A-ry-A/RobotSTM32Board/Robot_BMS/images/Robot_BMS_V1.png

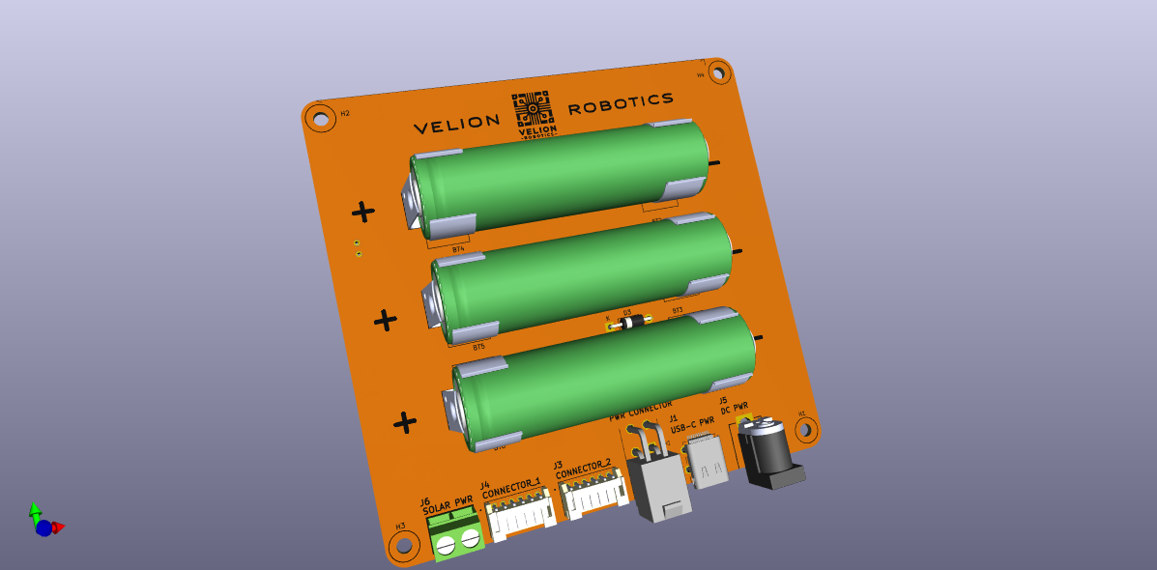
Robot_BMS/images/Robot_BMS_V1.png
