A-ry-A/RobotSTM32Board/Robot_BMS/images/boardlayout.jpg

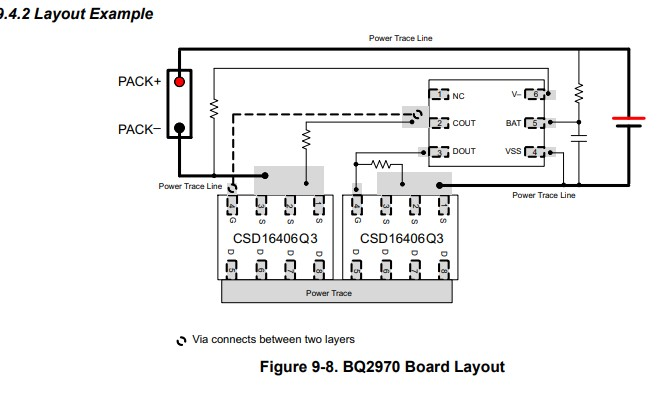
Robot_BMS/images/boardlayout.jpg
