A-ry-A/RobotSTM32Board/Robot_BMS/39-30-0040/3D/39-30-0040.stp

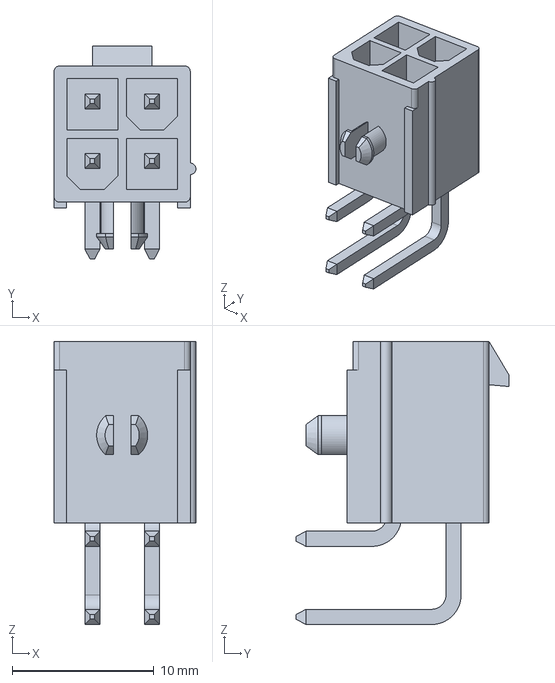
[picture p3: CAD file, 2025-03-24]
Robot_BMS/39-30-0040/3D/39-30-0040.stp
10.0 x 15.0 x 19.9 mm
