A-ry-A/RobotSTM32Board/Robot_BMS/BK_18650_CLIP (1)/BK-18650-CLIP.step

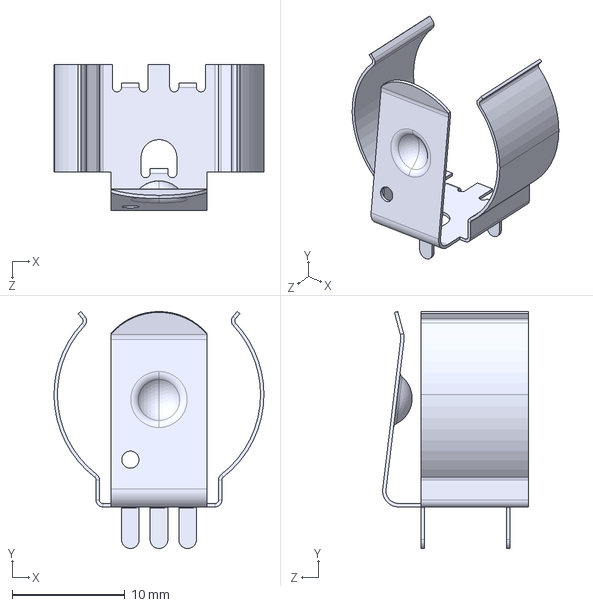
[picture p4: CAD file, 2025-03-24]
Robot_BMS/BK_18650_CLIP (1)/BK-18650-CLIP.step
18.6 x 21.0 x 12.9 mm
