A-ry-A/RobotSTM32Board/Robot_BMS/ERA-3AED512V/3D/ERA-3AED512V.stp

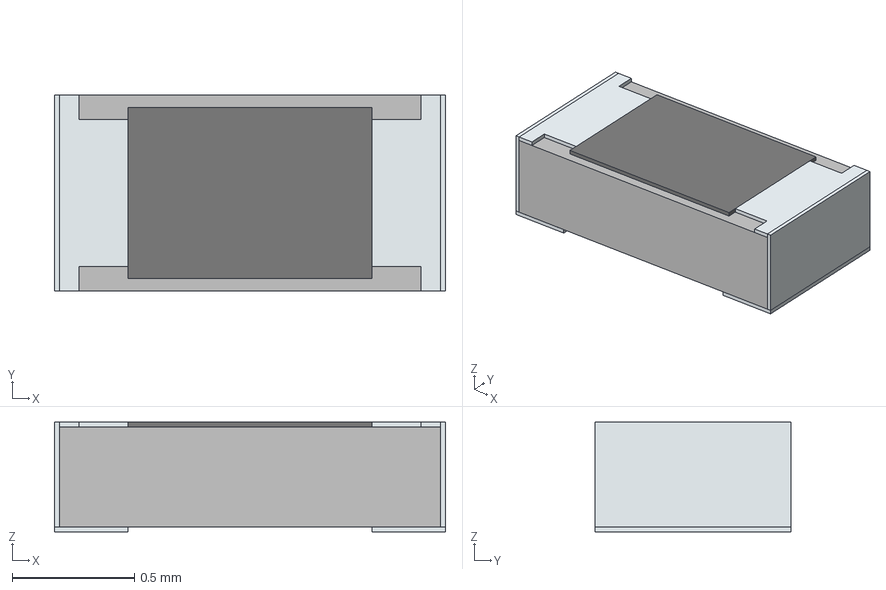
[picture p5: CAD file, 2025-03-24]
Robot_BMS/ERA-3AED512V/3D/ERA-3AED512V.stp
1.60 x 0.8 x 0.45 mm
solidBody
solidTop
solidTerminal1
solidTerminal2
solidTerminal3
