A-ry-A/RobotSTM32Board/Robot_BMS/NCP03XH103F05RL/3D/NCP03XH103F05RL.stp

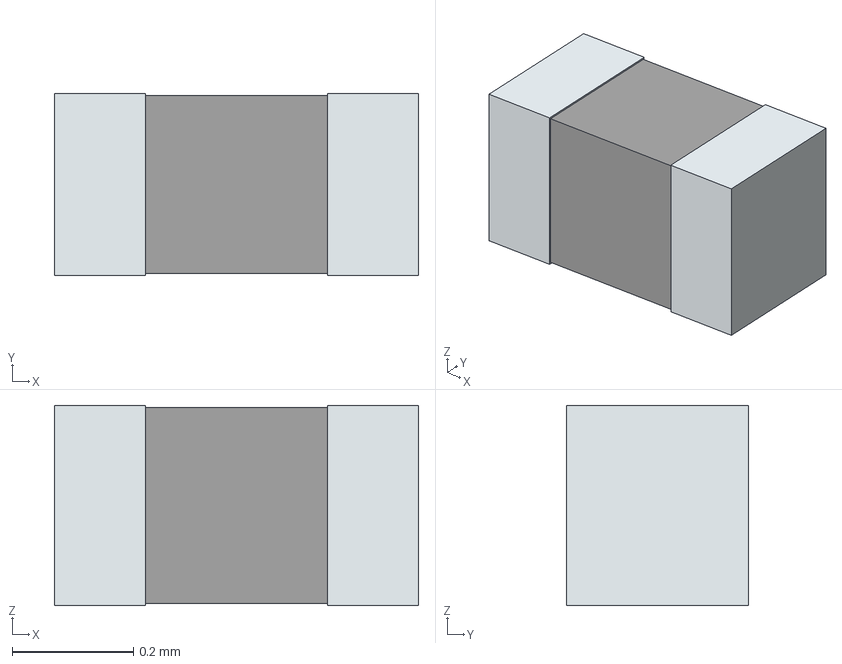
[picture p6: CAD file, 2025-03-24]
Robot_BMS/NCP03XH103F05RL/3D/NCP03XH103F05RL.stp
0.6 x 0.3 x 0.33 mm
term1
term2
