A-ry-A/RobotSTM32Board/Robot_BMS/Passive Components/AT0603DRE07100RL/AT0603DRE07100RL.step

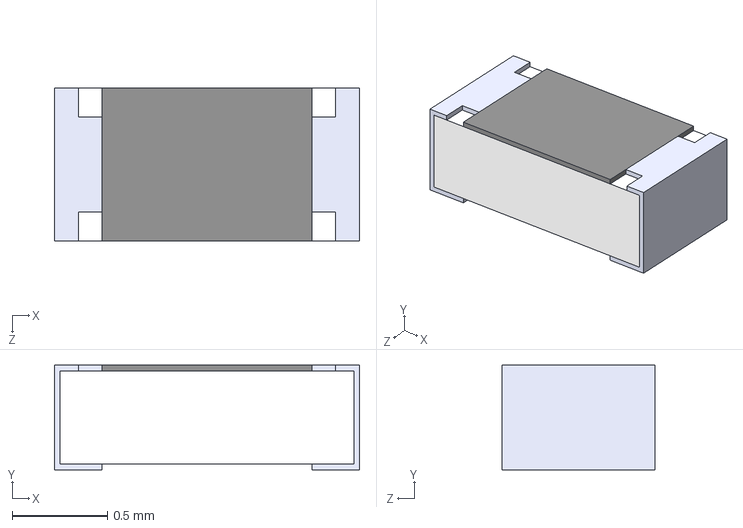
[picture p7: CAD file, 2025-03-19]
Robot_BMS/Passive Components/AT0603DRE07100RL/AT0603DRE07100RL.step
1.60 x 0.55 x 0.8 mm
