A-ry-A/RobotSTM32Board/Robot_BMS/Passive Components/CC0603KRX7R6BB184/CC0603KRX7R6BB184.step

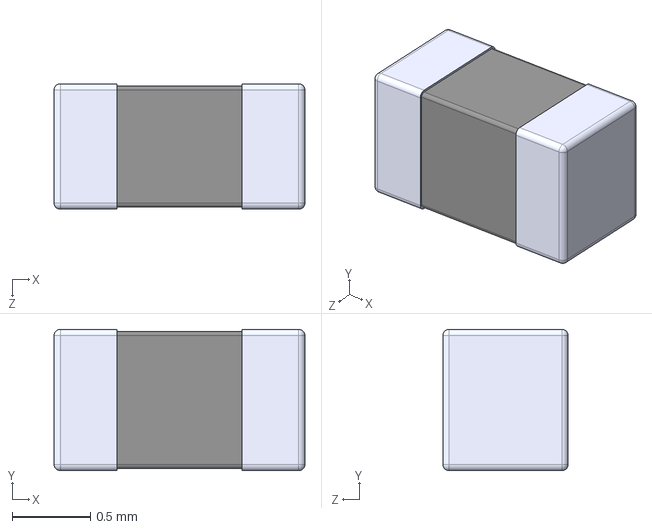
[picture p8: CAD file, 2025-03-19]
Robot_BMS/Passive Components/CC0603KRX7R6BB184/CC0603KRX7R6BB184.step
1.60 x 0.9 x 0.8 mm
