A-ry-A/RobotSTM32Board/Robot_BMS/Passive Components/CL10A106MA8NRNC/3D/CL10A106MA8NRNC.stp

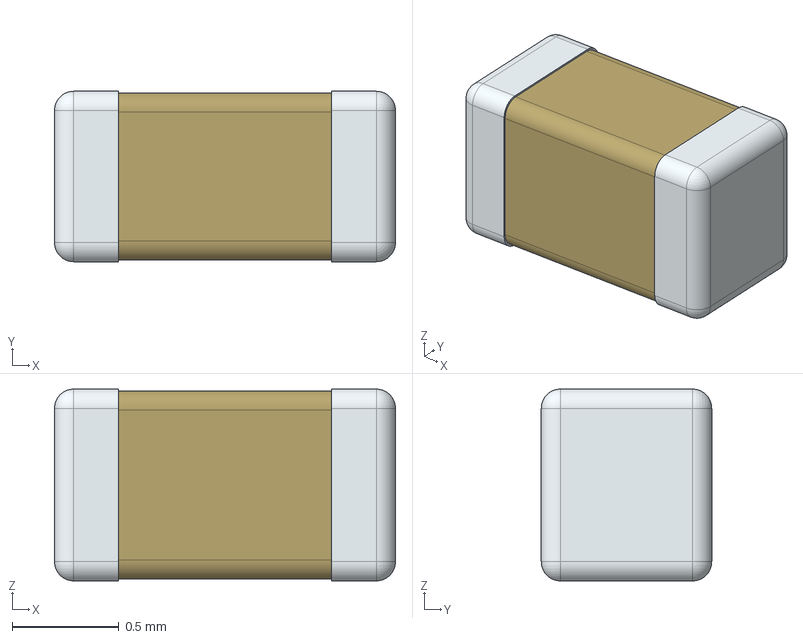
[picture p9: CAD file, 2025-03-19]
Robot_BMS/Passive Components/CL10A106MA8NRNC/3D/CL10A106MA8NRNC.stp
1.60 x 0.8 x 0.9 mm
