A-ry-A/RobotSTM32Board/Robot_BMS/Passive Components/CRCW0603110KFKEAC/CRCW0603110KFKEAC.step

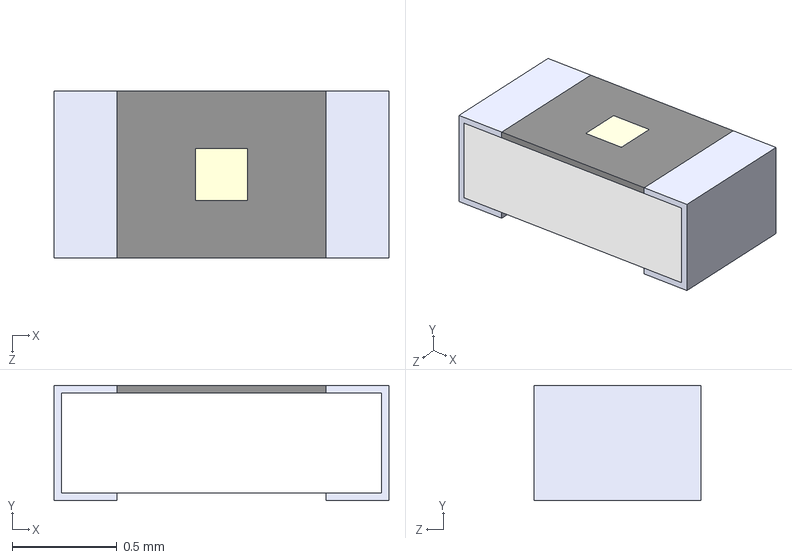
[picture p10: CAD file, 2025-03-19]
Robot_BMS/Passive Components/CRCW0603110KFKEAC/CRCW0603110KFKEAC.step
1.60 x 0.55 x 0.8 mm
