A-ry-A/RobotSTM32Board/Robot_BMS/Passive Components/CRCW060340K2FKEAHP/CRCW060340K2FKEAHP.step

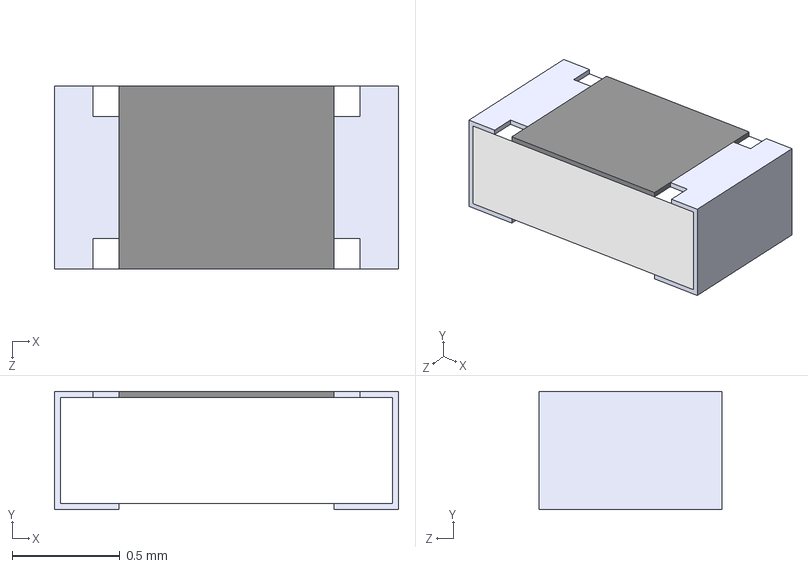
[picture p11: CAD file, 2025-03-19]
Robot_BMS/Passive Components/CRCW060340K2FKEAHP/CRCW060340K2FKEAHP.step
1.60 x 0.55 x 0.85 mm
