A-ry-A/RobotSTM32Board/Robot_BMS/Passive Components/CRCW0603604RFKEA/CRCW0603604RFKEA.step

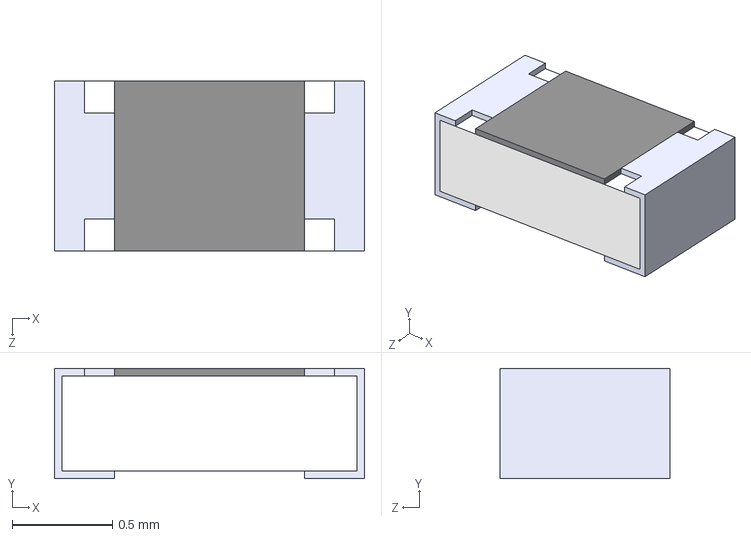
[picture p12: CAD file, 2025-03-19]
Robot_BMS/Passive Components/CRCW0603604RFKEA/CRCW0603604RFKEA.step
1.55 x 0.55 x 0.85 mm
