A-ry-A/RobotSTM32Board/Robot_BMS/Passive Components/ERJPA3F20R0V/ERJPA3F20R0V.step

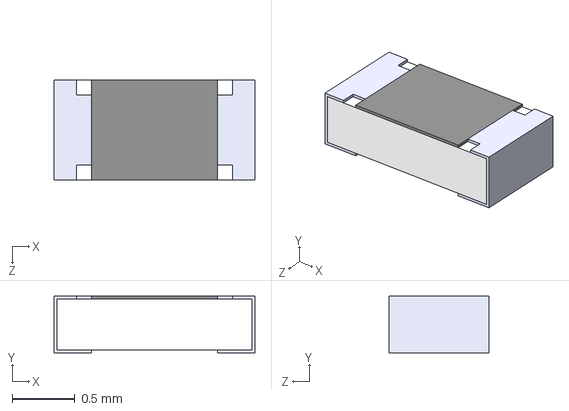
[picture p13: CAD file, 2025-03-19]
Robot_BMS/Passive Components/ERJPA3F20R0V/ERJPA3F20R0V.step
1.60 x 0.45 x 0.8 mm
