A-ry-A/RobotSTM32Board/Robot_BMS/Passive Components/GA0603A101JXBAC31G/GA0603A101JXBAC31G.step

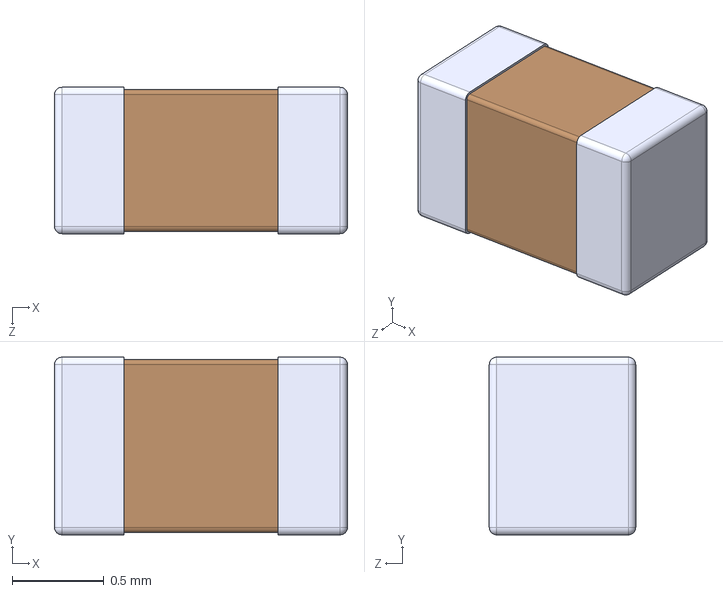
[picture p14: CAD file, 2025-03-19]
Robot_BMS/Passive Components/GA0603A101JXBAC31G/GA0603A101JXBAC31G.step
1.60 x 0.97 x 0.8 mm
