A-ry-A/RobotSTM32Board/Robot_BMS/Passive Components/LIB_ETQ-P5M220YSC/ETQ-P5M220YSC/3D/ETQ-P5M220YSC.stp

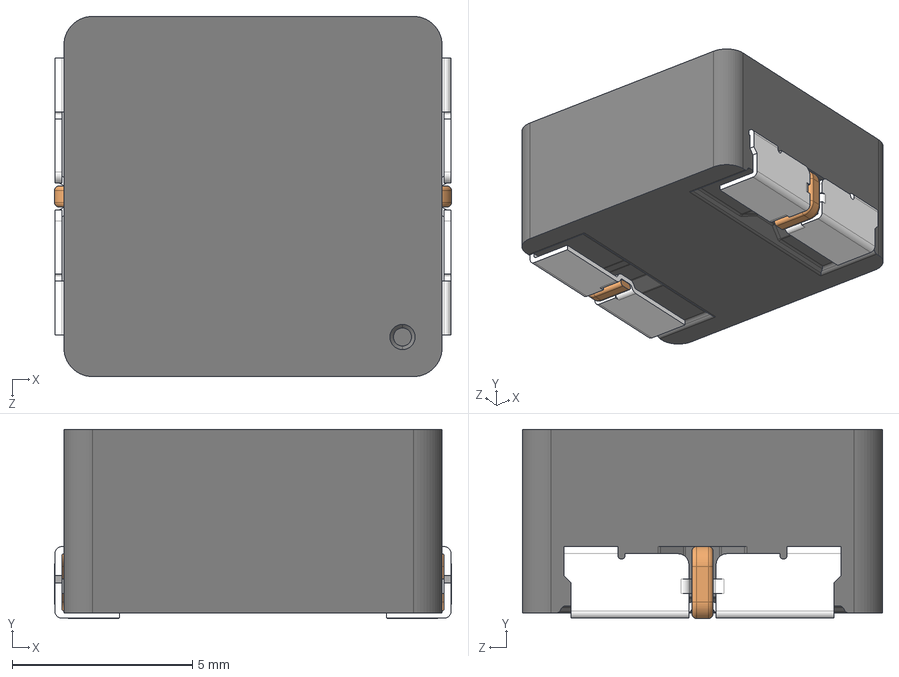
[picture p15: CAD file, 2025-03-19]
Robot_BMS/Passive Components/LIB_ETQ-P5M220YSC/ETQ-P5M220YSC/3D/ETQ-P5M220YSC.stp
11.0 x 5.25 x 10.0 mm
