A-ry-A/RobotSTM32Board/Robot_BMS/Passive Components/NTCLE100E3103HB0/NTCLE100E3102.step

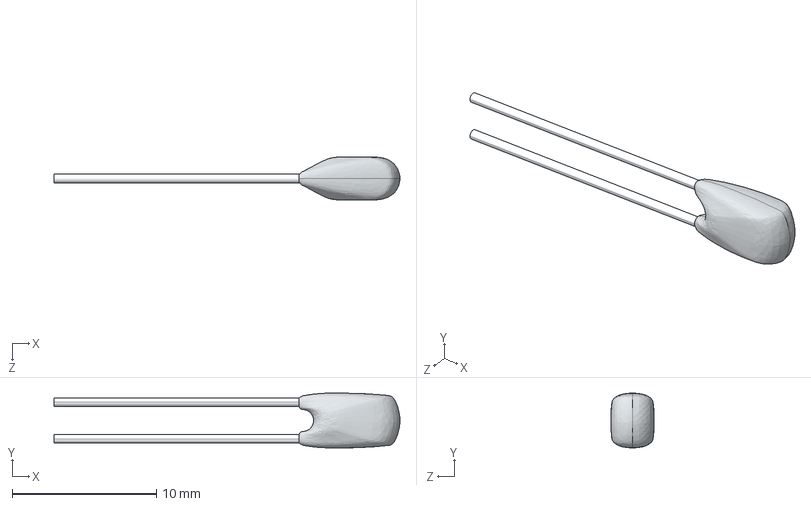
[picture p16: CAD file, 2025-03-19]
Robot_BMS/Passive Components/NTCLE100E3103HB0/NTCLE100E3102.step
24.0 x 3.80 x 3.00 mm
