A-ry-A/RobotSTM32Board/Robot_BMS/Passive Components/RC0603FR_073K24L/RC0603N_YAG.step

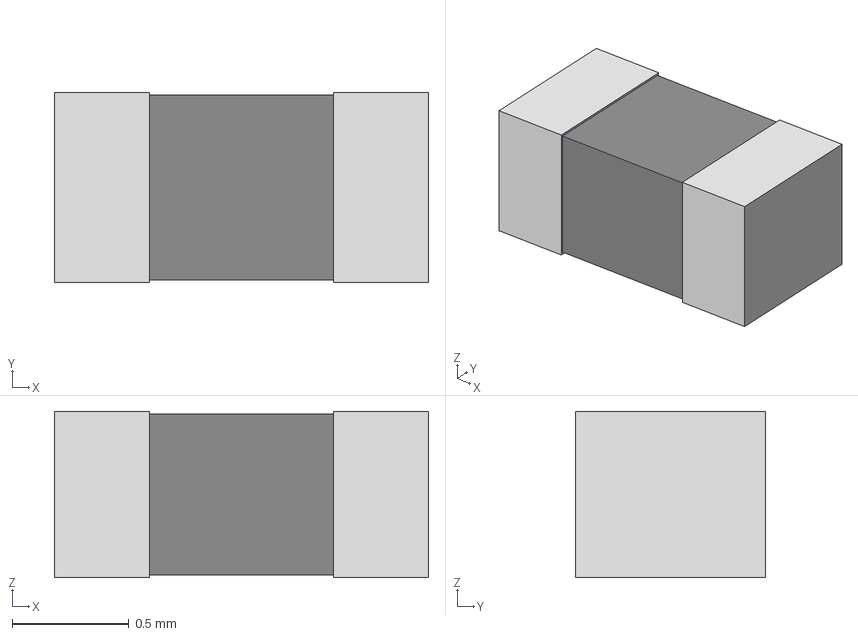
[picture p17: CAD file, 2025-03-19]
Robot_BMS/Passive Components/RC0603FR_073K24L/RC0603N_YAG.step
1.60 x 0.812 x 0.711 mm
