A-ry-A/RobotSTM32Board/Robot_BMS/Passive Components/RN73H1JTTD4811B25/RN73H1JTTD4811B25.step

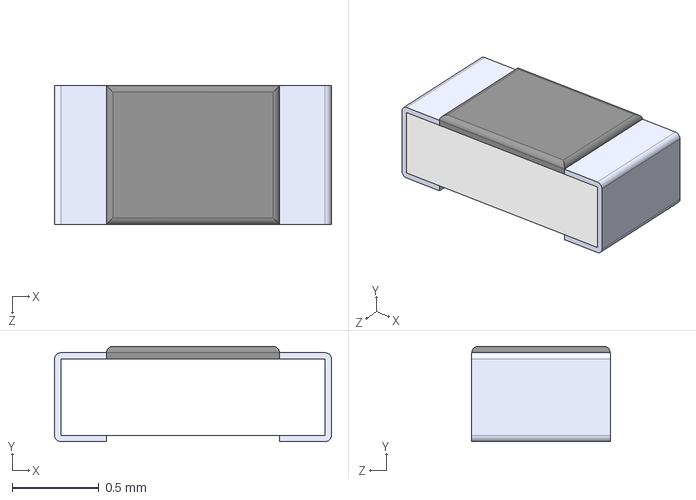
[picture p18: CAD file, 2025-03-19]
Robot_BMS/Passive Components/RN73H1JTTD4811B25/RN73H1JTTD4811B25.step
1.60 x 0.55 x 0.8 mm
