A-ry-A/RobotSTM32Board/Robot_BMS/Passive Components/ul_C0603C104K5RACAUTO/CCS_CCSTD_0603_L1.75W0.95T0.87B0.35.step

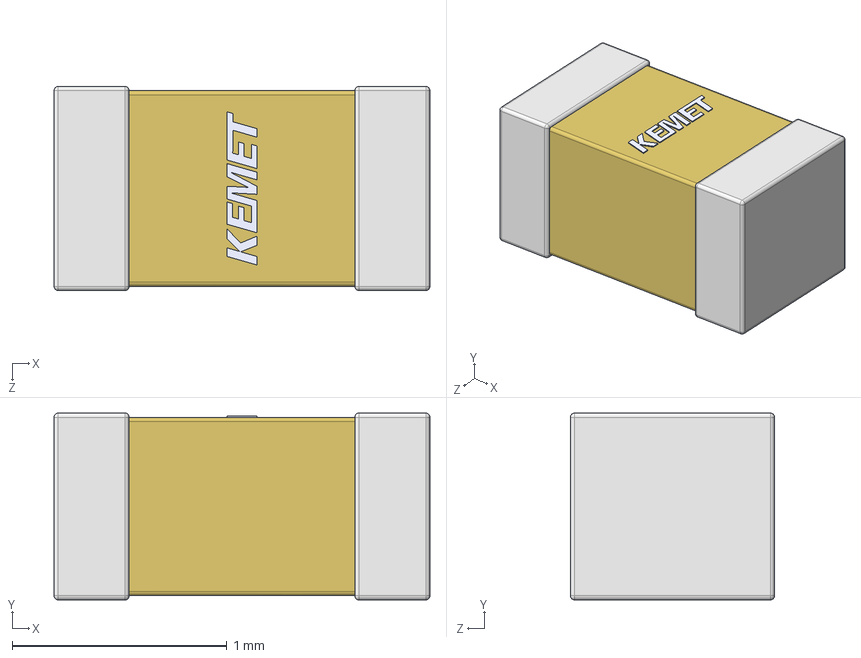
[picture p19: CAD file, 2025-03-19]
Robot_BMS/Passive Components/ul_C0603C104K5RACAUTO/CCS_CCSTD_0603_L1.75W0.95T0.87B0.35.step
1.75 x 0.87 x 0.95 mm
