A-ry-A/RobotSTM32Board/Robot_BMS/Passive Components/ul_C0603X821K5RACTU/CCS_CCSTD_0603_L1.77W0.95T0.95B0.45.step

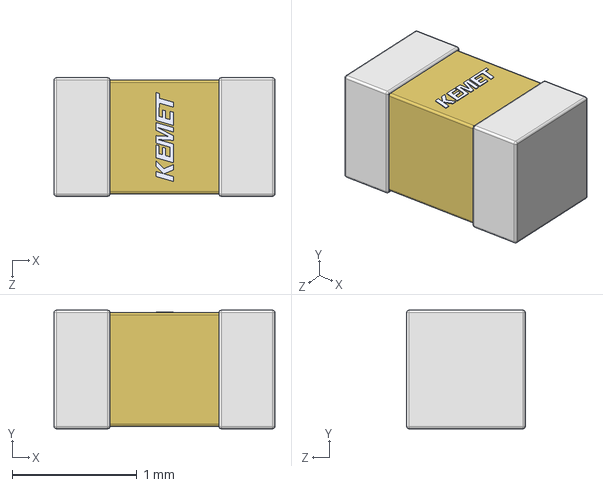
[picture p20: CAD file, 2025-03-19]
Robot_BMS/Passive Components/ul_C0603X821K5RACTU/CCS_CCSTD_0603_L1.77W0.95T0.95B0.45.step
1.77 x 0.95 x 0.95 mm
