A-ry-A/RobotSTM32Board/Robot_BMS/Passive Components/ul_C1608X5R1H105K080AB/CAP_1608_TDK.step

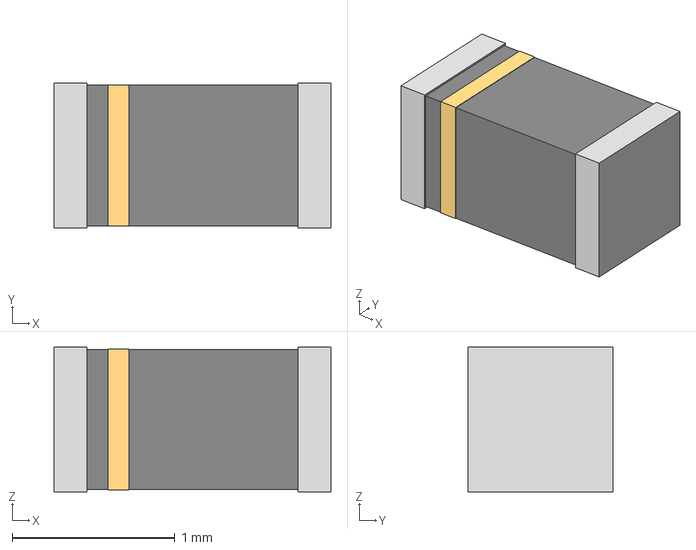
[picture p21: CAD file, 2025-03-19]
Robot_BMS/Passive Components/ul_C1608X5R1H105K080AB/CAP_1608_TDK.step
1.70 x 0.888 x 0.889 mm
