A-ry-A/RobotSTM32Board/Robot_BMS/Passive Components/ul_CRCW06031K00JNEAIF/RES_V0603_VIS.step

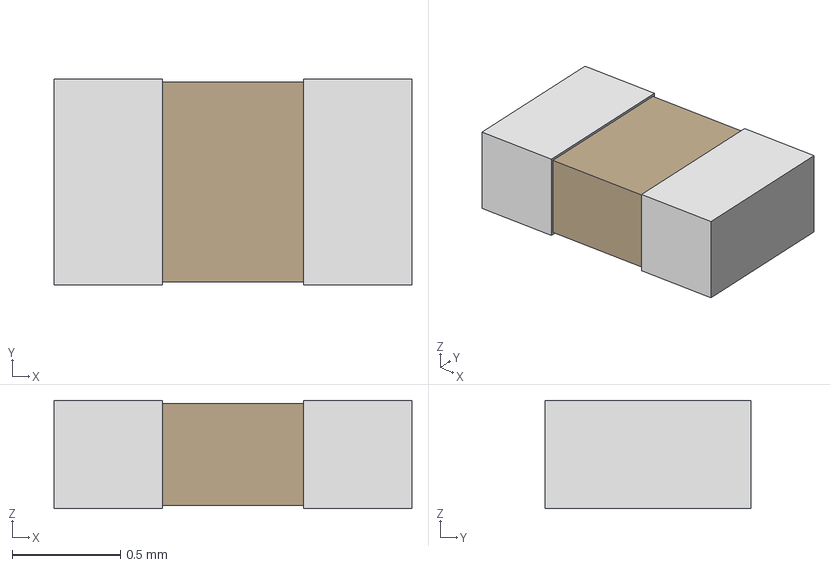
[picture p22: CAD file, 2025-03-19]
Robot_BMS/Passive Components/ul_CRCW06031K00JNEAIF/RES_V0603_VIS.step
1.65 x 0.95 x 0.5 mm
