A-ry-A/RobotSTM32Board/Robot_BMS/Passive Components/ul_ESR03EZPF1003/RES_R0603_ROM.step

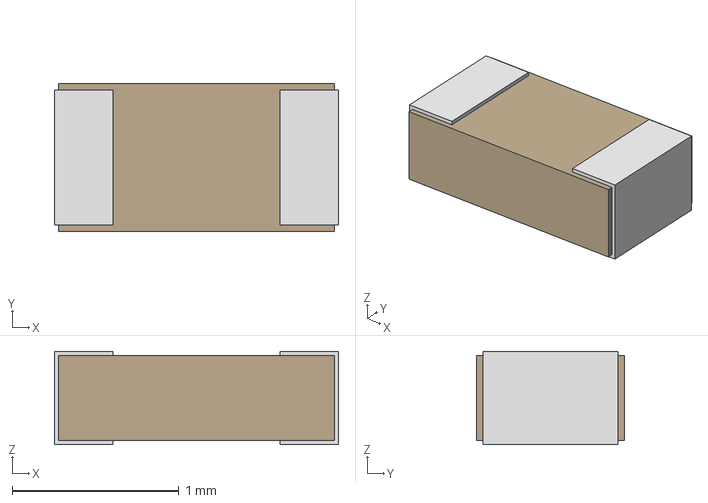
[picture p23: CAD file, 2025-03-19]
Robot_BMS/Passive Components/ul_ESR03EZPF1003/RES_R0603_ROM.step
1.70 x 0.888 x 0.559 mm
