A-ry-A/RobotSTM32Board/Robot_BMS/Passive Components/ul_GRM188R61H225KE11D/CAP_GRM188R61H225KE11__MUR.step

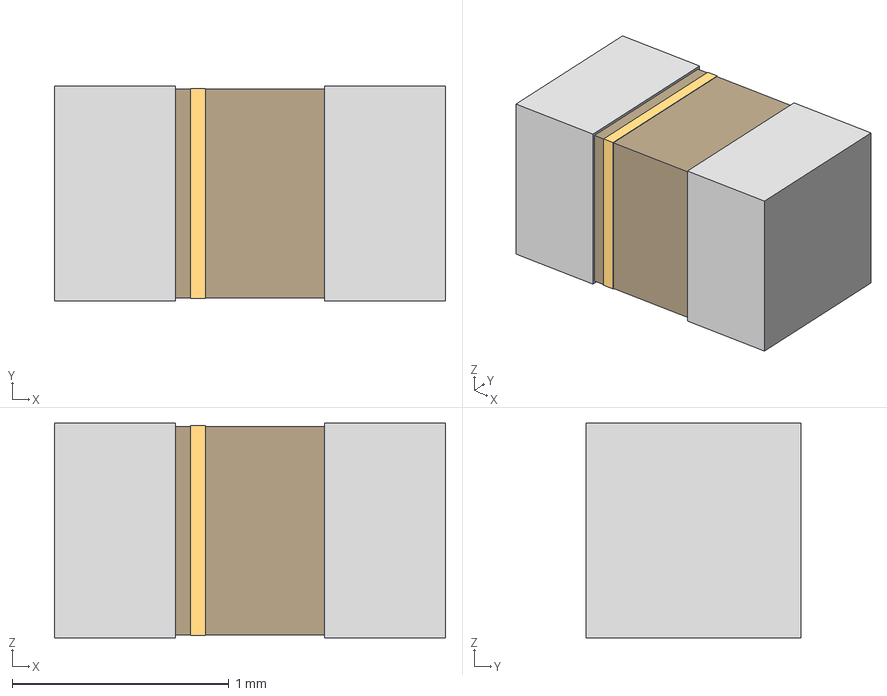
[picture p24: CAD file, 2025-03-19]
Robot_BMS/Passive Components/ul_GRM188R61H225KE11D/CAP_GRM188R61H225KE11__MUR.step
1.80 x 0.99 x 0.991 mm
