A-ry-A/RobotSTM32Board/Robot_BMS/Passive Components/ZRB18AR6YA475ME05L/ZRB18AR6YA475ME05L.step

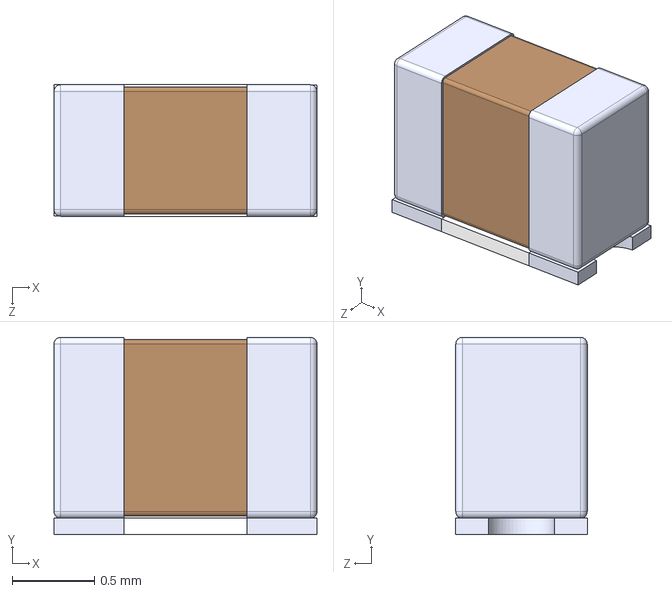
[picture p25: CAD file, 2025-03-19]
Robot_BMS/Passive Components/ZRB18AR6YA475ME05L/ZRB18AR6YA475ME05L.step
1.60 x 1.20 x 0.8 mm
