A-ry-A/RobotSTM32Board/Robot_BMS/PRT-13113/3D/PRT-13113.stp

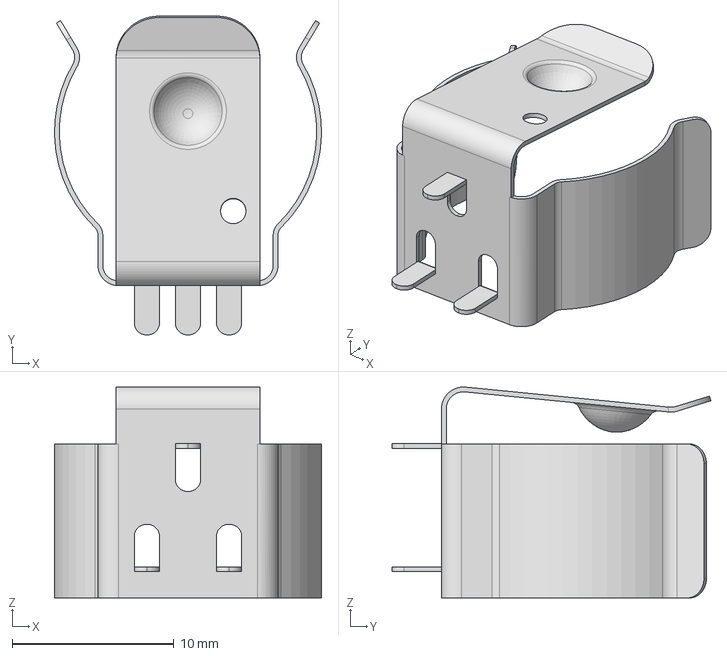
[picture p26: CAD file, 2025-04-03]
Robot_BMS/PRT-13113/3D/PRT-13113.stp
16.5 x 19.7 x 13.0 mm
