A-ry-A/RobotSTM32Board/Robot_BMS/Robot_BMS.step

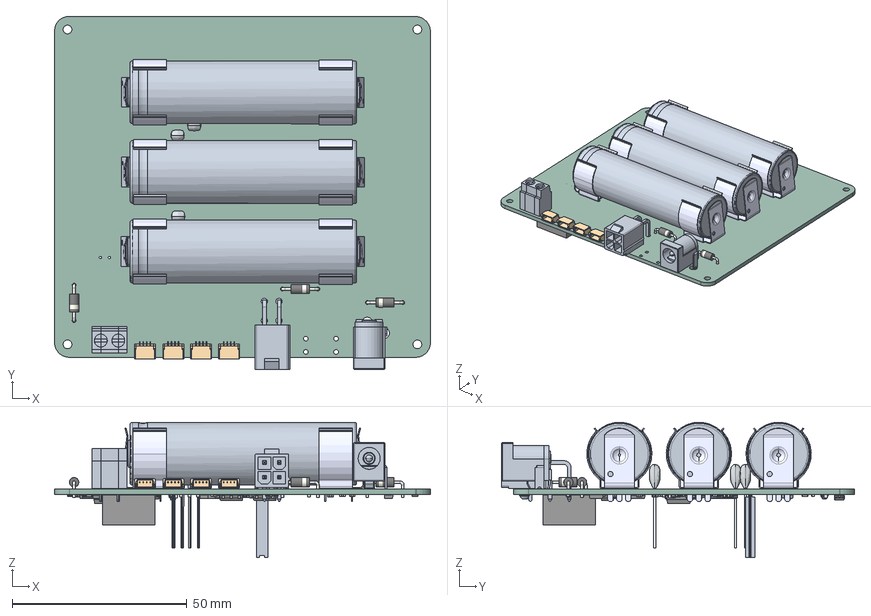
[picture p27: CAD file, 2025-04-18]
Robot_BMS/Robot_BMS.step
107.5 x 100.9 x 38.7 mm
SM04B-SRSS-TB(LFSN) x 4
DCJ200-10-A-K1-K
D_DO-41_SOD81_P10.16mm_Horizontal x 3
BK-18650-CLIP x 6
NTCLE100bModel2 STP x 3
18650 Battery 01A v1 x 3
Assem1
RSN0032B_ASM
DGK8
DQJ0008A_ASM
ERJ3RSFR10V x 6
SOT_223 x 2
ASSEMBLY x 5
SOT_23_6
ESR03EZPF1001 x 7
SQ7415AEN-T1 x 2
SOT_23 x 2
SMCJ15A-13-F
MF-USML_12-t3
Robot_BMS_PCB
