A-ry-A/RobotSTM32Board/Robot_BMS/S6B-PH-K-S_LF__SN_/S6B-PH-K-S_LF__SN_.step

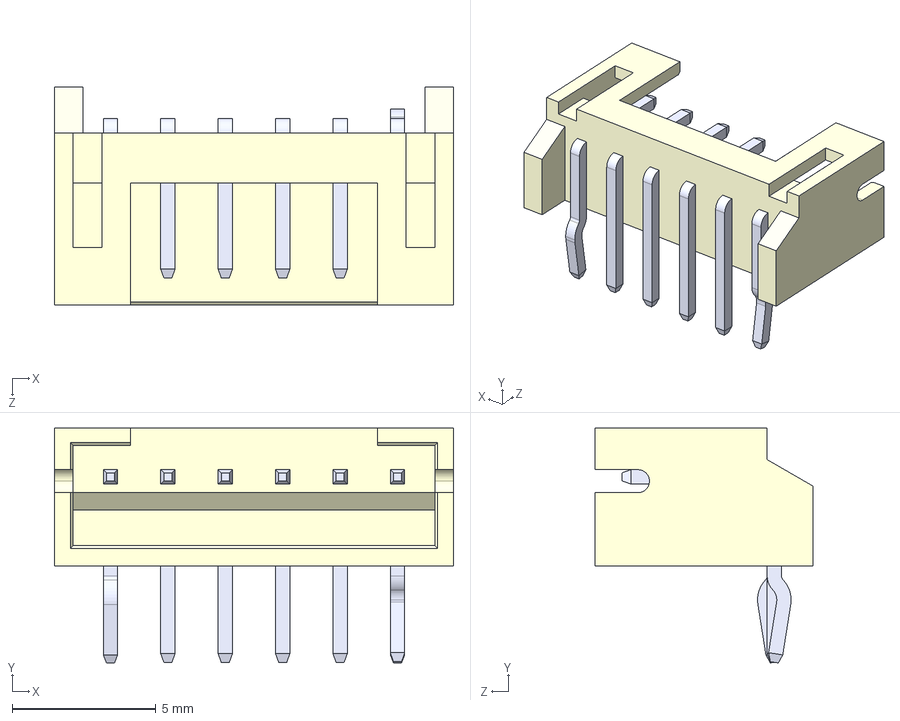
[picture p28: CAD file, 2025-03-24]
Robot_BMS/S6B-PH-K-S_LF__SN_/S6B-PH-K-S_LF__SN_.step
13.9 x 8.18 x 7.60 mm
