A-ry-A/RobotSTM32Board/Robot_BMS/UJC-H-G-SMT-2-P6-TR/3D/UJC-H-G-SMT-2-P6-TR.stp

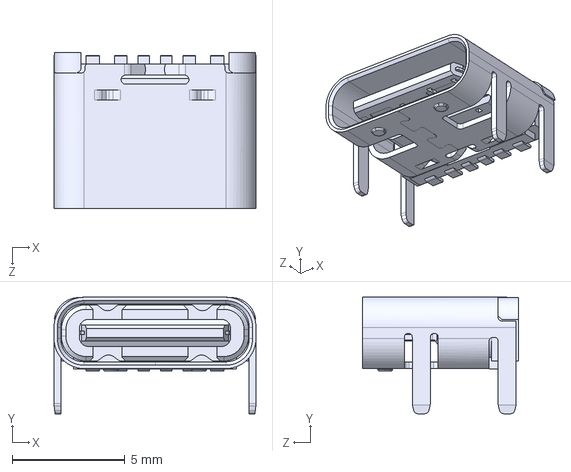
[picture p29: CAD file, 2025-04-01]
Robot_BMS/UJC-H-G-SMT-2-P6-TR/3D/UJC-H-G-SMT-2-P6-TR.stp
8.94 x 5.16 x 6.90 mm
