A-ry-A/RobotSTM32Board/Robot_BMS/ul_MF-LSMF500-16X-2/MF-USML450_12.stp

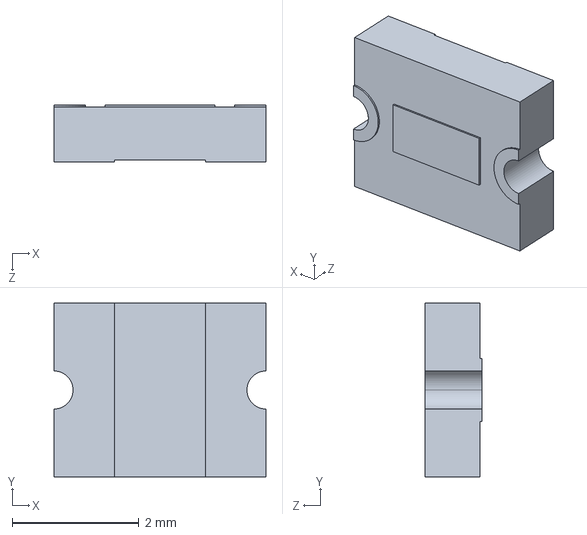
[picture p30: CAD file, 2025-03-24]
Robot_BMS/ul_MF-LSMF500-16X-2/MF-USML450_12.stp
3.34 x 2.74 x 0.9 mm
