A-ry-A/RobotSTM32Board/Robot_BMS/UR73D1JTTD10L0F/3D/UR73D1JTTD10L0F.stp

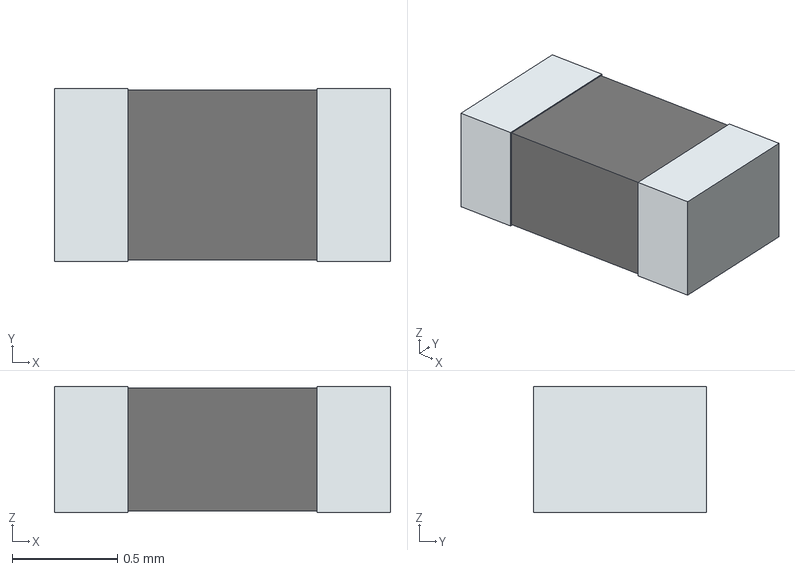
[picture p31: CAD file, 2025-03-24]
Robot_BMS/UR73D1JTTD10L0F/3D/UR73D1JTTD10L0F.stp
1.60 x 0.825 x 0.6 mm
term1
term2
