A-ry-A/RobotSTM32Board/TB6612FNG/TB6612FNG.step

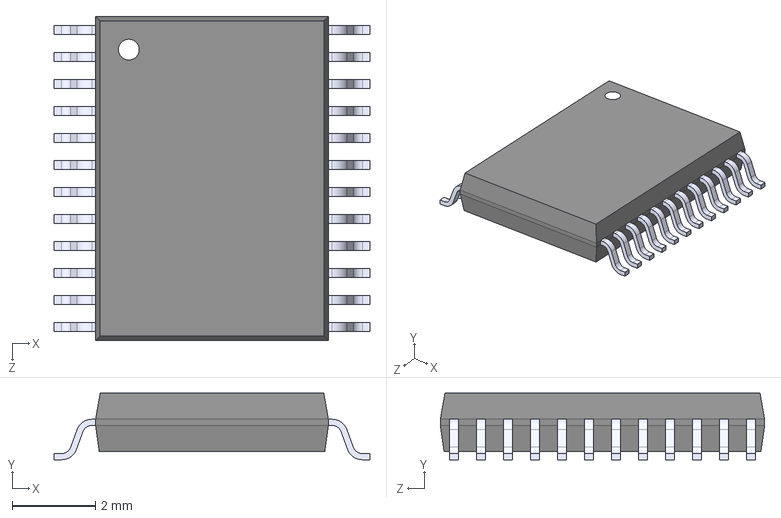
[picture p32: CAD file, 2025-03-03]
TB6612FNG/TB6612FNG.step
7.60 x 1.60 x 7.80 mm
