A-ry-A/RobotSTM32Board/(list of files, cad)

Other CAD files:
Robot_BMS/Passive Components/ul_C1608X5R1H474K080AB/CAP_1608_TDK.step
Robot_BMS/Passive Components/ul_RC0603FR-0710KL/RC0603N_YAG.step
Robot_BMS/AP33772DKZ-13/3D/AP33772DKZ-13.stp
