A-ry-A/RobotSTM32Board/Robot_BMS/Robot_BMS.kicad_pcb

## KiCad design Robot_BMS/Robot_BMS.kicad_pcb (2025-04-18)

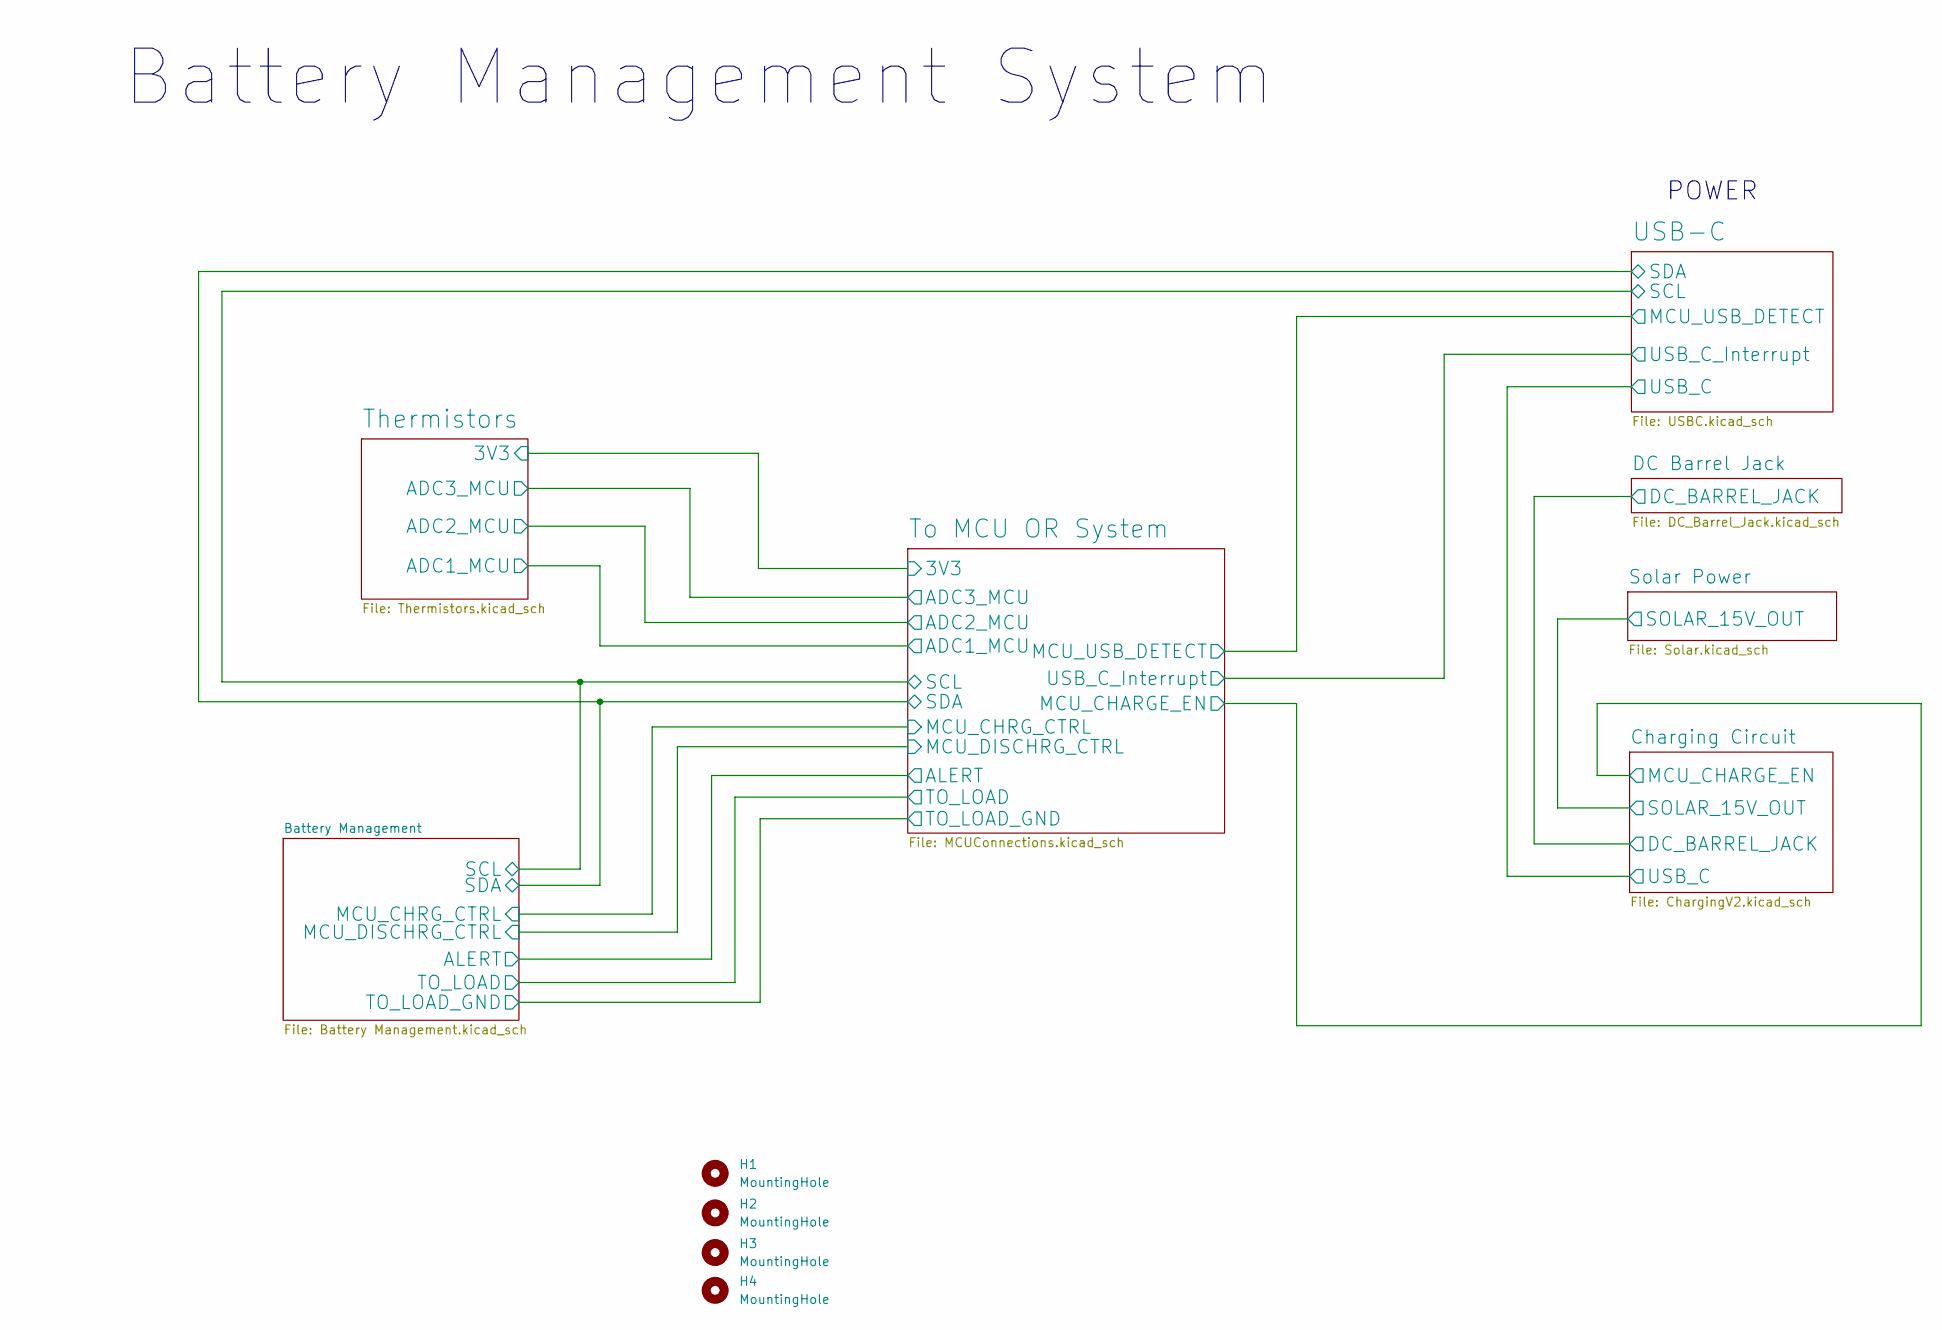
[picture p33: schematic Robot_BMS.kicad_sch, Battery Management System]

Parts:
H1, H2, H3, H4: MountingHole; MountingHole_2.5mm

Notes on the sheet:
POWER
Battery Management System

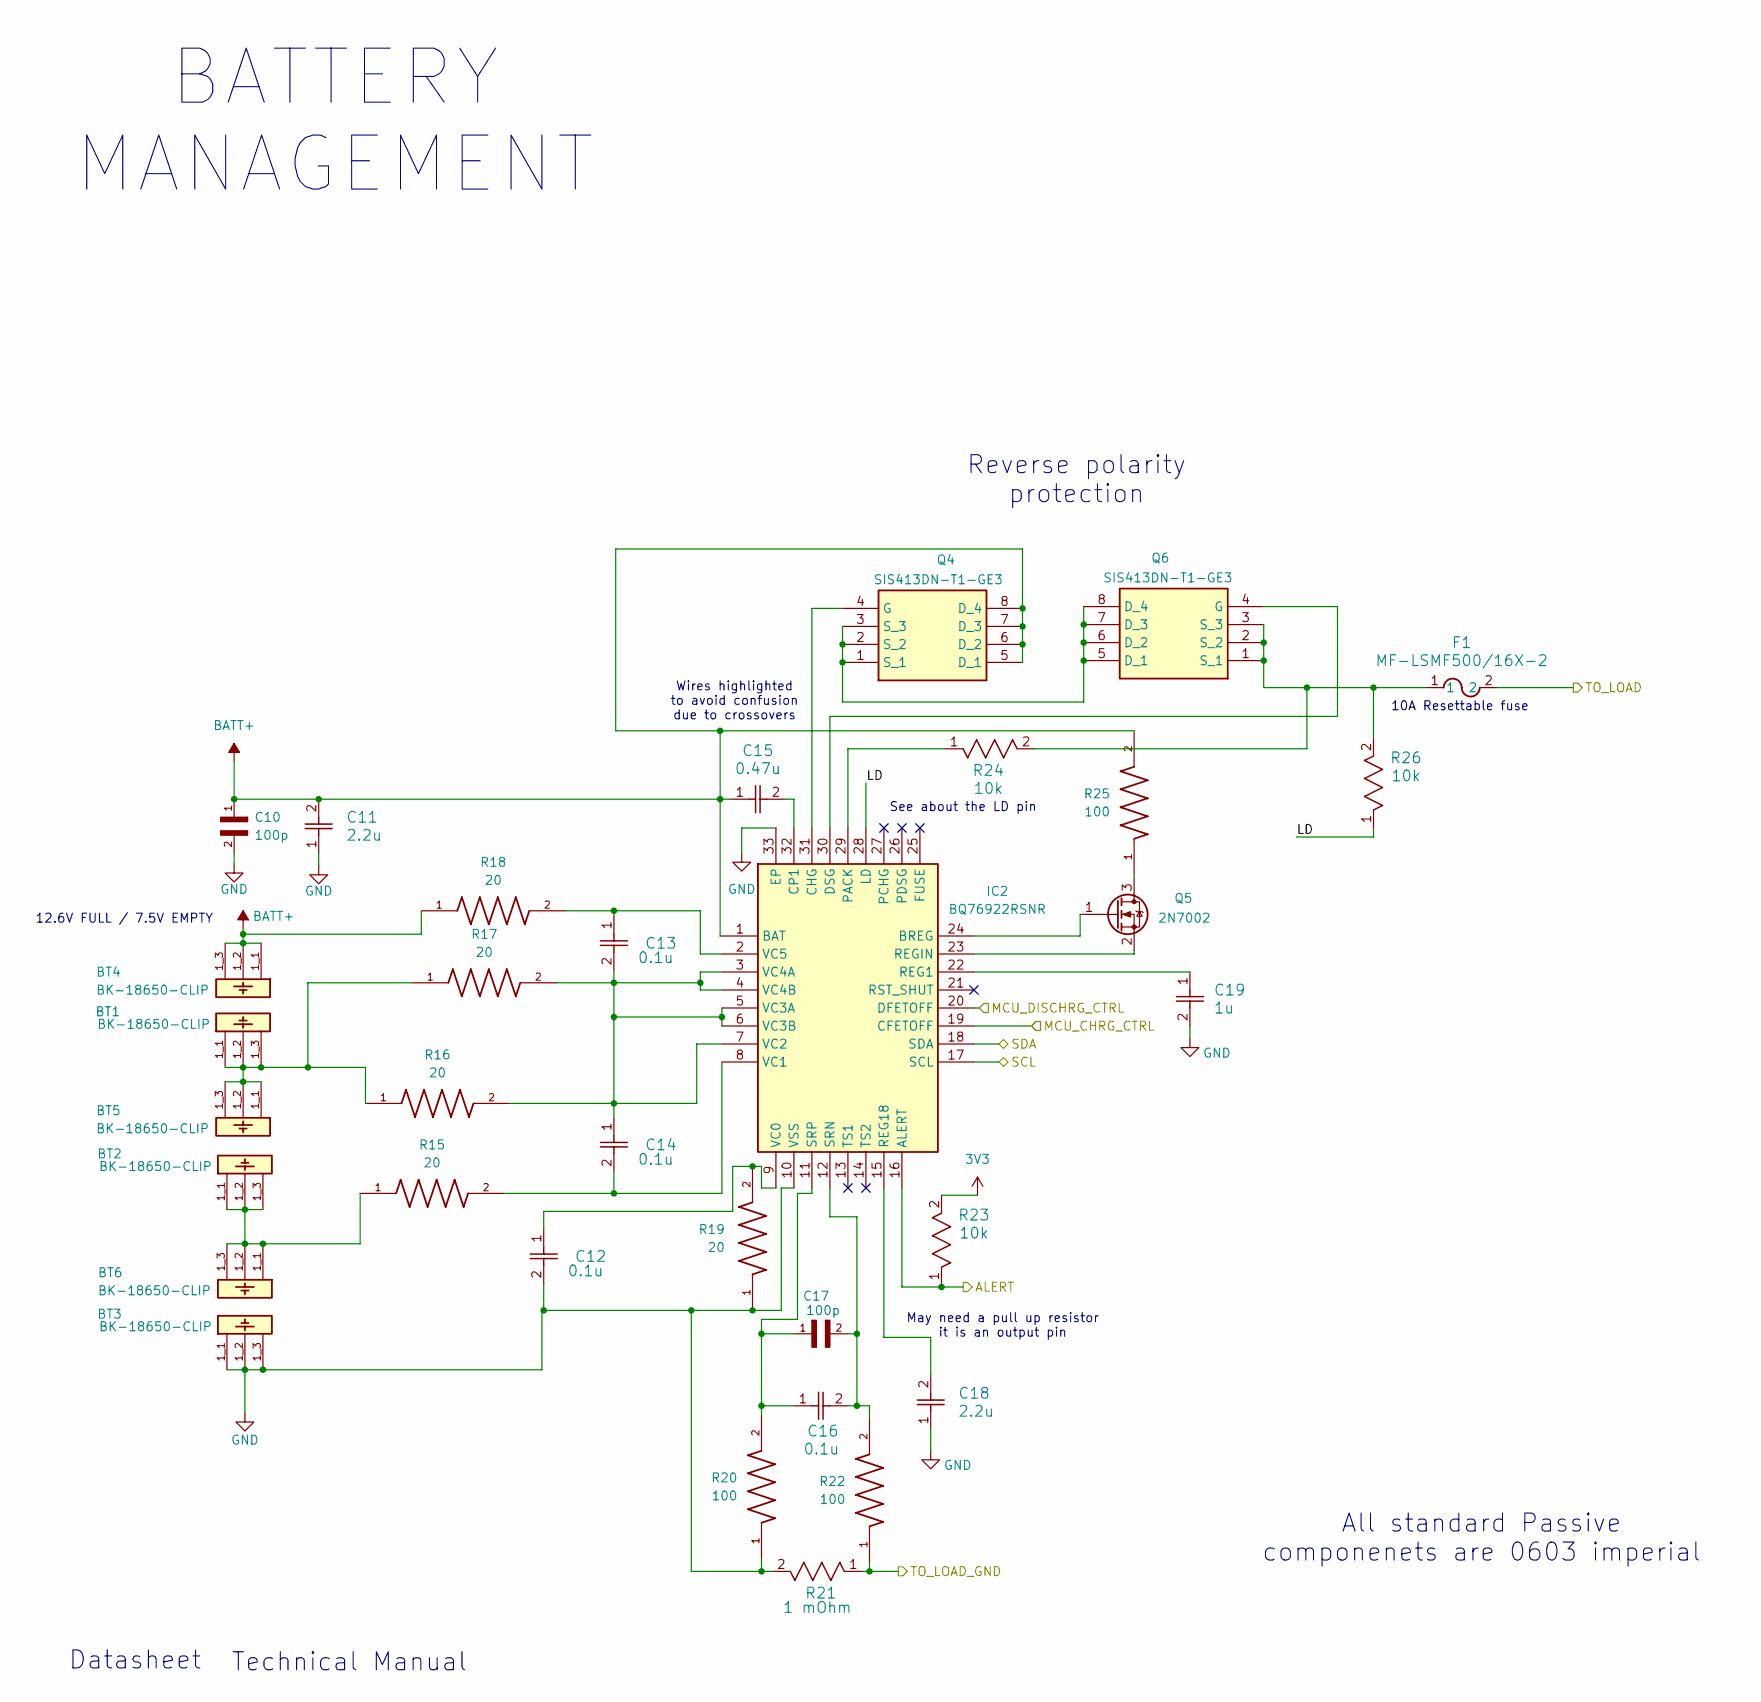
[picture p34: schematic Battery Management.kicad_sch]

Parts:
BT1, BT2, BT3, BT4, BT5, BT6: BK-18650-CLIP; BAT_BK-18650-CLIP; PARTREV A
C10, C17: 100p; CAPC1608X97N; Manufacturer_Part_Number GA0603A101JXBAC31G
C11, C18: 2.2u; CAP_GRM188R61H225KE11__MUR; Manufacturer_Part_Number GRM188R61H225KE11D
C12, C13, C14, C16: 0.1u; CAPC17595_87N_KEM; Manufacturer_Part_Number C0603C104K5RACAUTO
C15: 0.47u; CAP_1608_TDK; Manufacturer_Part_Number C1608X5R1H474K080AB
C19: 1u; CAP_1608_TDK; Manufacturer_Part_Number C1608X5R1H105K080AB
F1: MF-LSMF500/16X-2; FUSE_MF-LSMF185&slash_33X_BRN
IC2: BQ76922RSNR; QFN40P400X400X80-33N-D; Manufacturer_Part_Number BQ76922RSNR
Q4, Q6: SIS413DN-T1-GE3; SIS862DNT1GE3; Manufacturer_Part_Number SIS413DN-T1-GE3; Mouser Part Number 78-SIS413DN-T1-GE3
Q5: 2N7002; SOT-23; Manufacturer_Part_Number 2N7002 H6327
R15, R16, R17, R18, R19: 20; RES_ERJPA3F20R0V; PARTREV 3/1/2020
R20, R22, R25: 100; RESC1608X55N; PARTREV V6
R21: 1 mOhm; RC0603N_YAG; Manufacturer_Part_Number 580060716002
R23, R24, R26: 10k; RC0603N_YAG; Manufacturer_Part_Number RC0603FR-0710KL

Connections:
3V3: R23.2; also elsewhere on the board
/Battery Management/ALERT: IC2.16 (ALERT), R23.1; also elsewhere on the board
/Battery Management/LD: IC2.28 (LD), R26.1
/Battery Management/MCU_CHRG_CTRL: IC2.19 (CFETOFF); also elsewhere on the board
/Battery Management/MCU_DISCHRG_CTRL: IC2.20 (DFETOFF); also elsewhere on the board
/Battery Management/SCL: IC2.17 (SCL); also elsewhere on the board
/Battery Management/SDA: IC2.18 (SDA); also elsewhere on the board
/Battery Management/TO_LOAD: F1.2; also elsewhere on the board
/Battery Management/TO_LOAD_GND: R21.1, R22.1; also elsewhere on the board
BATT+: BT4.1_1, BT4.1_2, BT4.1_3, C10.1, C11.2, C15.1, IC2.1 (BAT), Q4.5 (D_1), Q4.6 (D_2), Q4.7 (D_3), Q4.8 (D_4), Q4.9, Q4.10, Q4.11, R18.1, R25.2
GND: BT3.1_1, BT3.1_2, BT3.1_3, C10.2, C11.1, C12.2, C18.1, C19.2, IC2.10 (VSS), IC2.33 (EP), R19.1, R20.1, R21.2; also elsewhere on the board
unnamed: BT1.1_1, BT1.1_2, BT1.1_3, BT5.1_1, BT5.1_2, BT5.1_3, R16.1, R17.1
unnamed: BT2.1_1, BT2.1_2, BT2.1_3, BT6.1_1, BT6.1_2, BT6.1_3, R15.1
unnamed: IC2.24 (BREG), Q5.1 (G)
unnamed: IC2.31 (CHG), Q4.4 (G)
unnamed: C15.2, IC2.32 (CP1)
unnamed: IC2.30 (DSG), Q6.4 (G)
unnamed: IC2.29 (PACK), R24.1
unnamed: C19.1, IC2.22 (REG1)
unnamed: C18.2, IC2.15 (REG18)
unnamed: IC2.23 (REGIN), Q5.2 (S)
unnamed: C16.2, C17.2, IC2.12 (SRN), R22.2
unnamed: C16.1, C17.1, IC2.11 (SRP), R20.2
unnamed: C12.1, IC2.9 (VC0), R19.2
unnamed: C14.2, IC2.8 (VC1), R15.2
unnamed: C13.2, C14.1, IC2.3 (VC4A), IC2.4 (VC4B), IC2.5 (VC3A), IC2.6 (VC3B), IC2.7 (VC2), R16.2, R17.2
unnamed: C13.1, IC2.2 (VC5), R18.2
unnamed: Q4.1 (S_1), Q4.2 (S_2), Q4.3 (S_3), Q6.5 (D_1), Q6.6 (D_2), Q6.7 (D_3), Q6.8 (D_4), Q6.9, Q6.10, Q6.11
unnamed: Q5.3 (D), R25.1
unnamed: F1.1, Q6.1 (S_1), Q6.2 (S_2), Q6.3 (S_3), R24.2, R26.2

Notes on the sheet:
Wires highlighted to avoid confusion due to crossovers
May need a pull up resistor it is an output pin
Reverse polarity protection
Technical Manual
Datasheet
BATTERY MANAGEMENT
12.6V FULL / 7.5V EMPTY
See about the LD pin
All standard Passive componenets are 0603 imperial
10A Resettable fuse

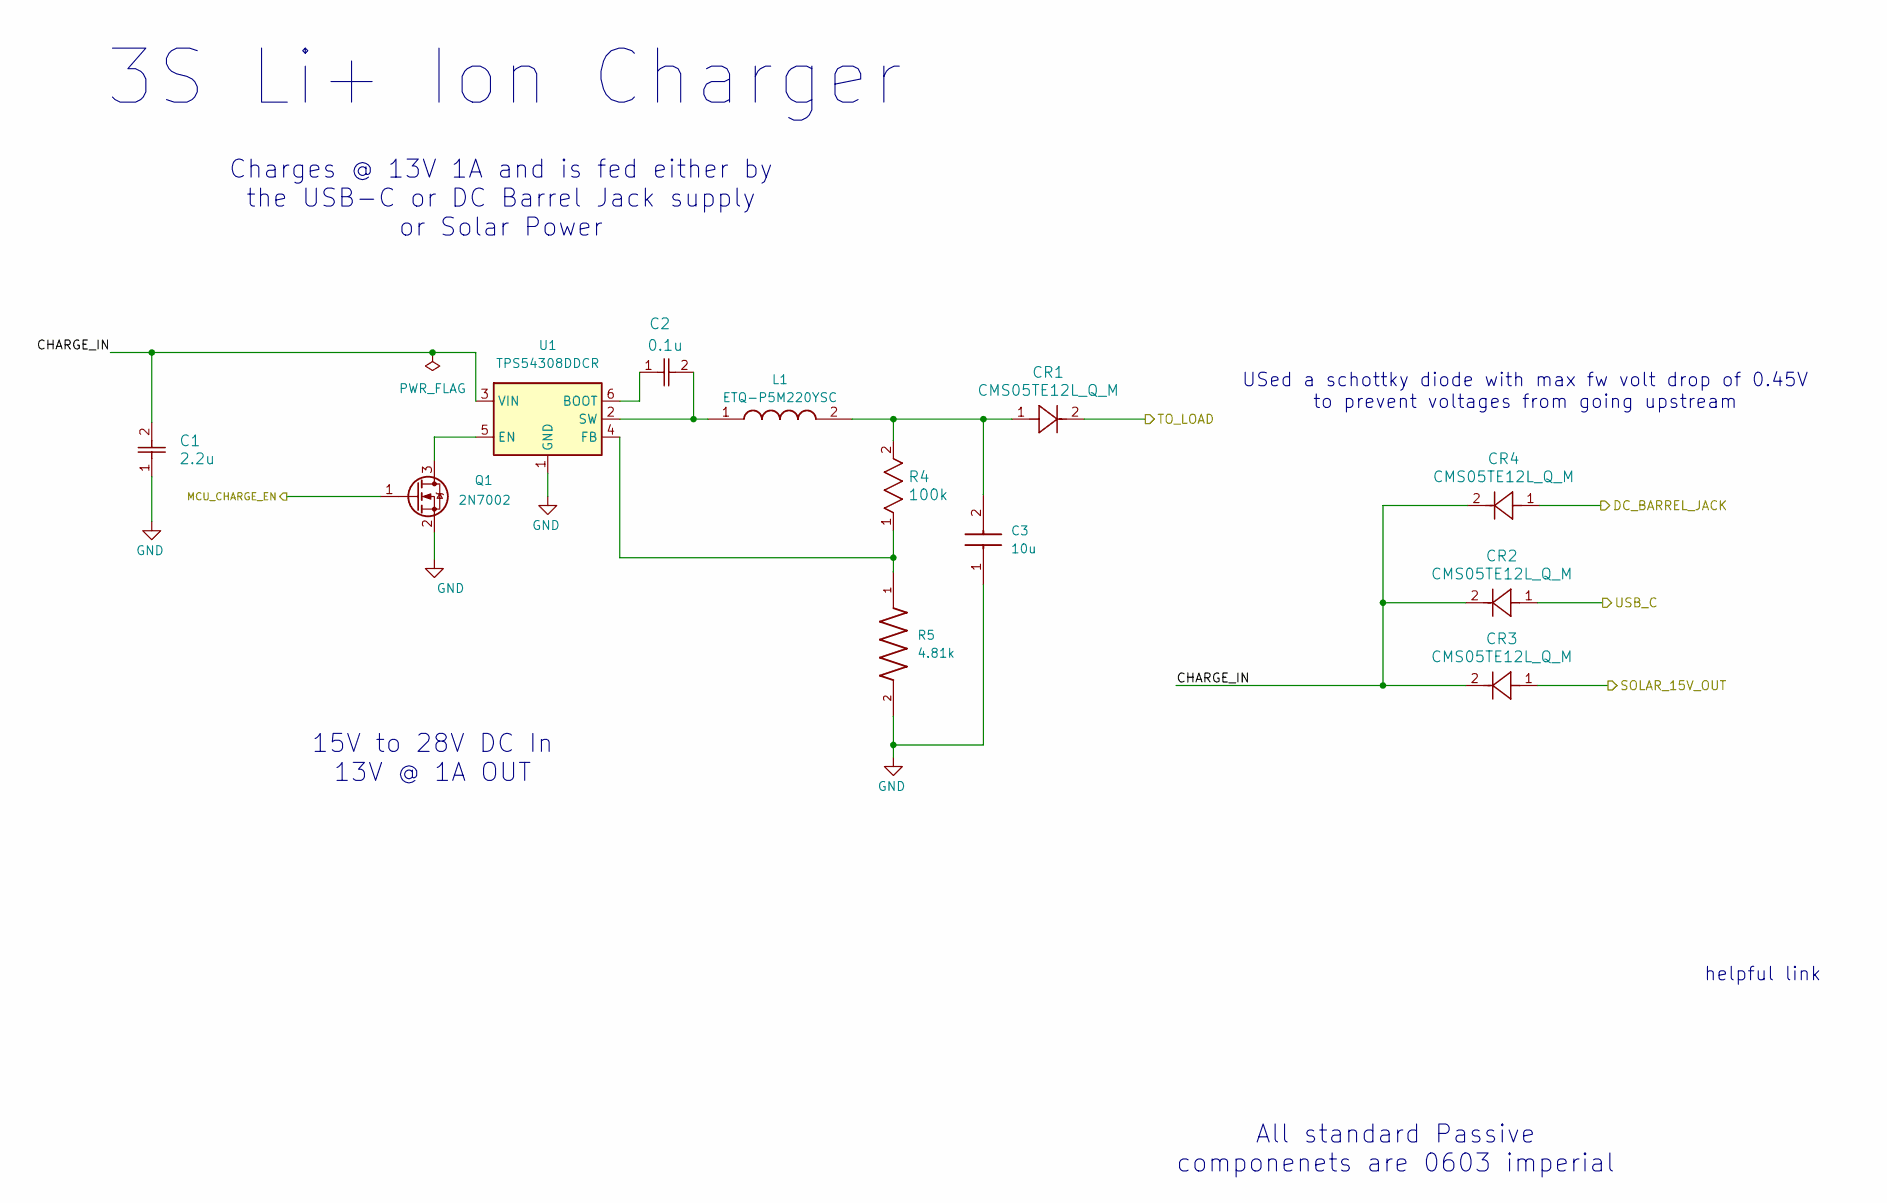
[picture p35: schematic ChargingV2.kicad_sch]

Parts:
C1: 2.2u; CAP_GRM188R61H225KE11__MUR; Manufacturer_Part_Number GRM188R61H225KE11D
C2: 0.1u; CAPC17595_87N_KEM; Manufacturer_Part_Number C0603C104K5RACAUTO
C3: 10u; CAPC1608X90N; Mouser Part Number 187-CL10A106MA8NRNC
CR1, CR2, CR3, CR4: CMS05TE12L_Q_M; M-FLAT_TOS; Manufacturer_Part_Number CMS05TE12L_Q_M
L1: ETQ-P5M220YSC; ETQP5M220YSC; Manufacturer_Part_Number ETQ-P5M220YSC
Q1: 2N7002; SOT-23; Manufacturer_Part_Number 2N7002 H6327
R4: 100k; RES_R0603_ROM; Manufacturer_Part_Number ESR03EZPF1003
R5: 4.81k; RESC1608X55N; Manufacturer_Part_Number RN73H1JTTD4811B25
U1: TPS54308DDCR; SOT-23-6; Manufacturer_Part_Number TPS54308DDCR

Connections:
/Charging Circuit/CHARGE_IN: C1.2, CR2.2, CR3.2, CR4.2, U1.3 (VIN)
/Charging Circuit/DC_BARREL_JACK: CR4.1; also elsewhere on the board
/Charging Circuit/MCU_CHARGE_EN: Q1.1 (G); also elsewhere on the board
/Charging Circuit/SOLAR_15V_OUT: CR3.1; also elsewhere on the board
/Charging Circuit/TO_LOAD: CR1.2
/Charging Circuit/USB_C: CR2.1; also elsewhere on the board
GND: C1.1, C3.1, Q1.2 (S), R5.2, U1.1 (GND); also elsewhere on the board
unnamed: C3.2, CR1.1, L1.2, R4.2
unnamed: Q1.3 (D), U1.5 (EN)
unnamed: C2.1, U1.6 (BOOT)
unnamed: R4.1, R5.1, U1.4 (FB)
unnamed: C2.2, L1.1, U1.2 (SW)

Notes on the sheet:
helpful link
Charges @ 13V 1A and is fed either by the USB-C or DC Barrel Jack supply or Solar Power
USed a schottky diode with max fw volt drop of 0.45V to prevent voltages from going upstream
15V to 28V DC In 13V @ 1A OUT
3S Li+ Ion Charger
All standard Passive componenets are 0603 imperial

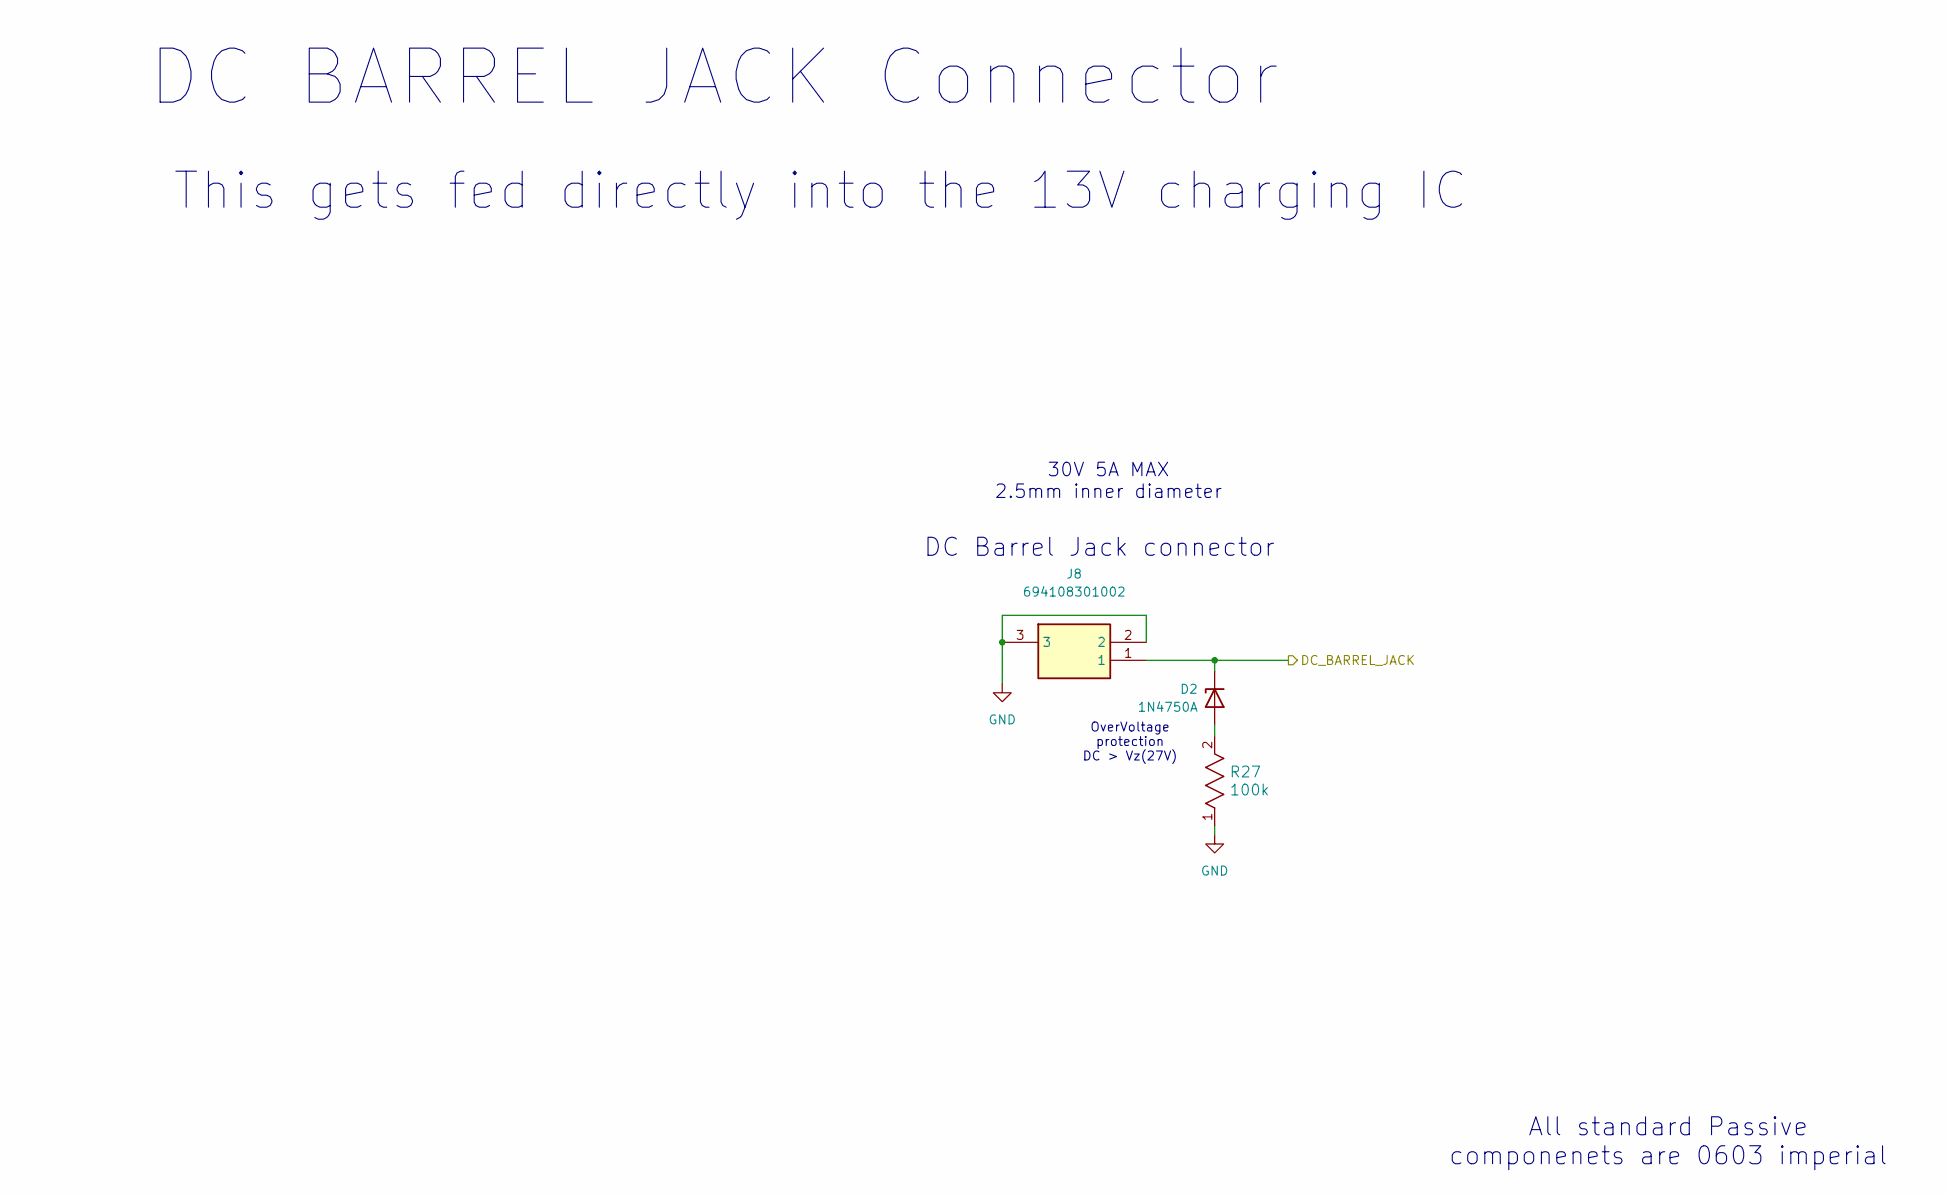
[picture p36: schematic DC_Barrel_Jack.kicad_sch]

Parts:
D2: 1N4750A; D_DO-41_SOD81_P10.16mm_Horizontal; Manufacturer_Part_Number 1N4750A
J8: 694108301002; Mouser Part Number 710-694108301002
R27: 100k; RES_R0603_ROM; Manufacturer_Part_Number ESR03EZPF1003

Connections:
/Charging Circuit/DC_BARREL_JACK: D2.1 (K), J8.1; also elsewhere on the board
GND: J8.2, J8.3, R27.1; also elsewhere on the board
unnamed: D2.2 (A), R27.2

Notes on the sheet:
All standard Passive componenets are 0603 imperial
OverVoltage protection DC > Vz(27V)
This gets fed directly into the 13V charging IC
30V 5A MAX 2.5mm inner diameter
DC Barrel Jack connector
DC BARREL JACK Connector

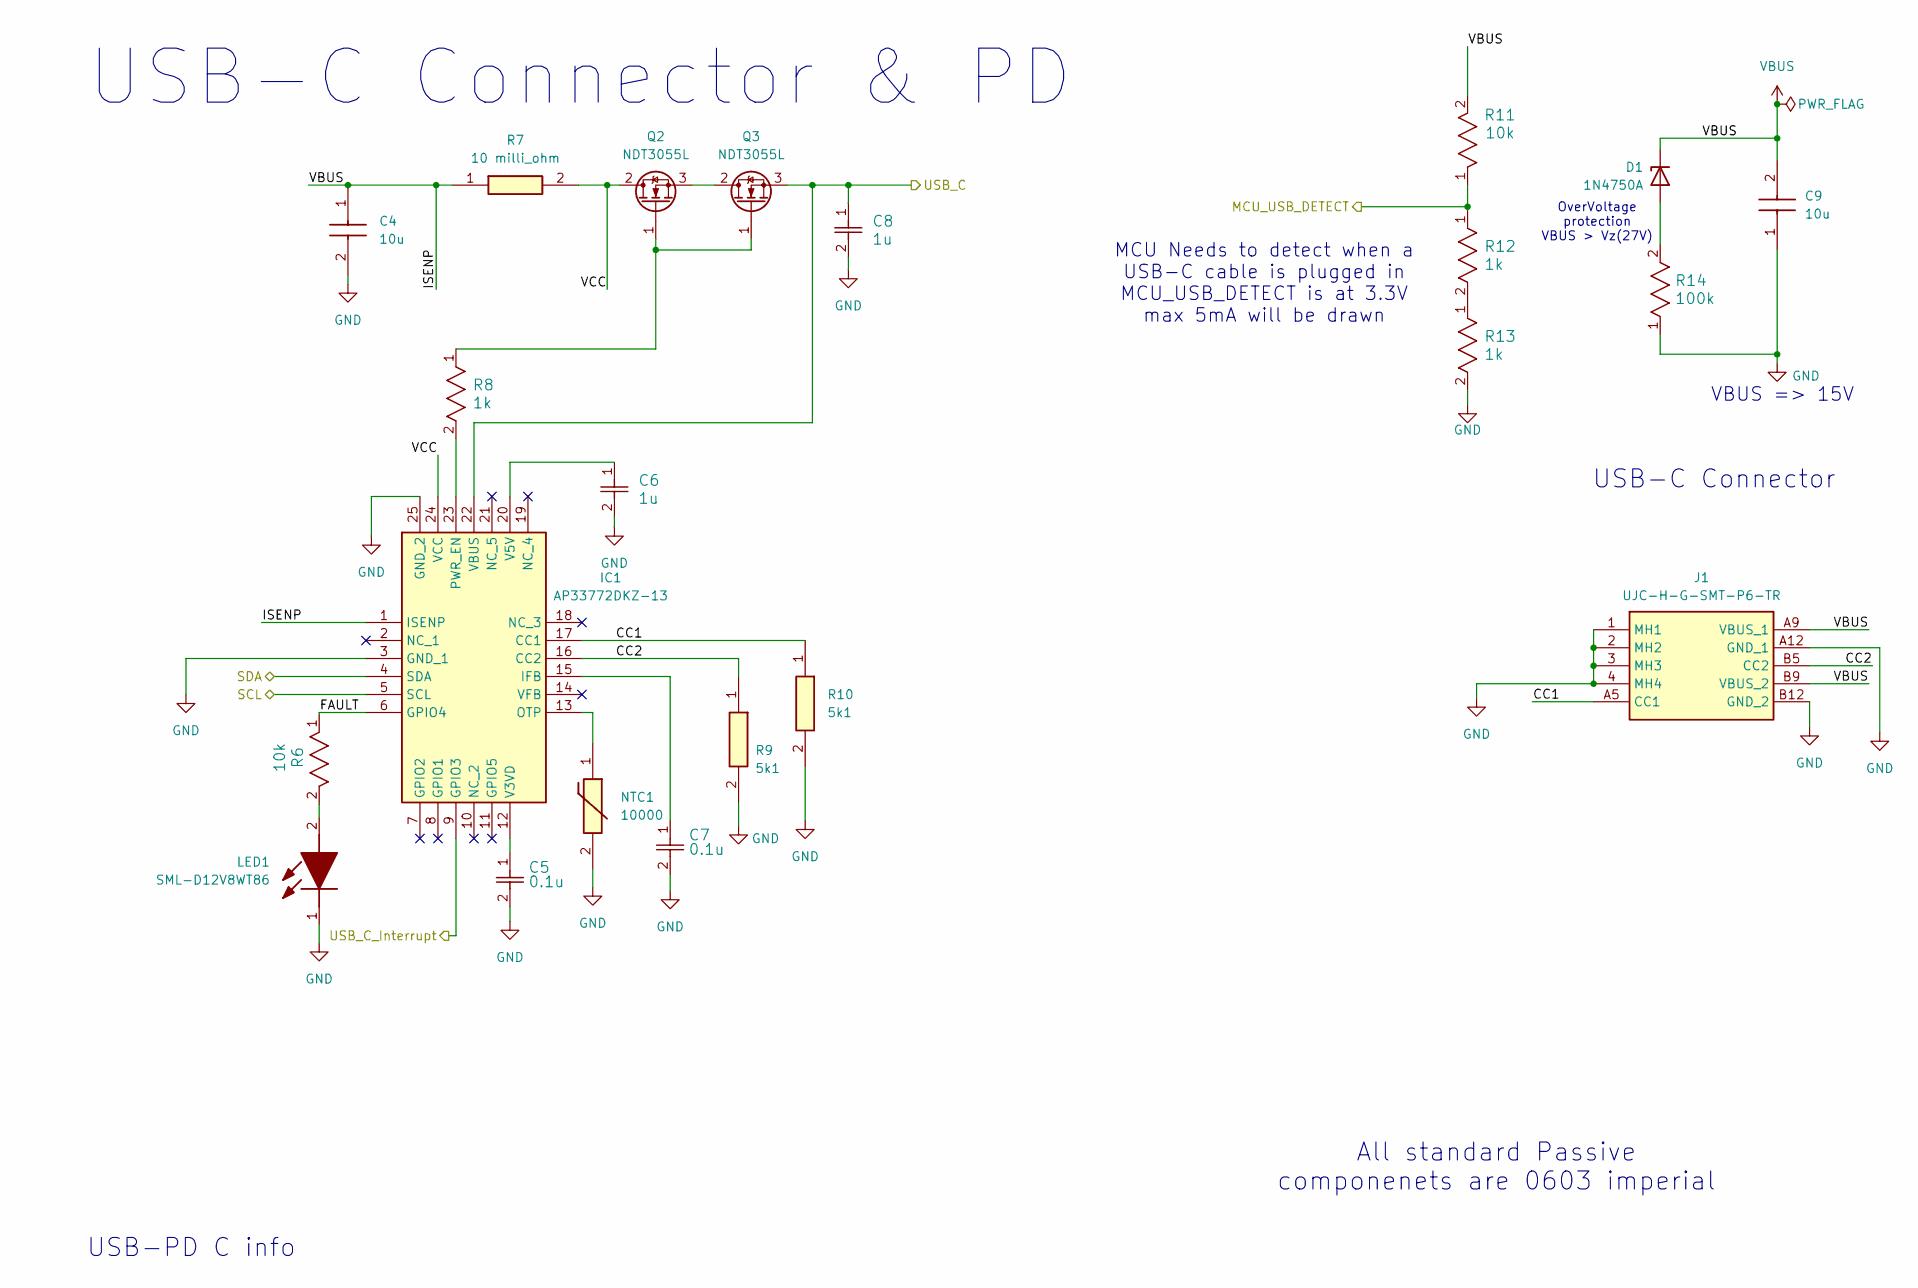
[picture p37: schematic USBC.kicad_sch]

Parts:
C4, C9: 10u; CAPC1608X90N; Mouser Part Number 187-CL10A106MA8NRNC
C5, C7: 0.1u; CAPC17595_87N_KEM; Manufacturer_Part_Number C0603C104K5RACAUTO
C6, C8: 1u; CAP_1608_TDK; Manufacturer_Part_Number C1608X5R1H105K080AB
D1: 1N4750A; D_DO-41_SOD81_P10.16mm_Horizontal; Manufacturer_Part_Number 1N4750A
IC1: AP33772DKZ-13; QFN50P400X400X80-25N-D; Mouser Part Number 621-AP33772DKZ-13
J1: UJC-H-G-SMT-P6-TR; UJCHGSMT2P6TR; Mouser Part Number 179-UJCHGSMT2P6TR
LED1: SML-D12V8WT86; SMLD12V8WT86; Mouser Part Number 755-SML-D12V8WT86
NTC1: 10000; THRMC0603X33N; Mouser Part Number 81-NCP03XH103F05RL
Q2, Q3: NDT3055L; SOT-223-3_TabPin2; Manufacturer_Part_Number NDT3055L
R6, R11: 10k; RC0603N_YAG; Manufacturer_Part_Number RC0603FR-0710KL
R7: 10 milli_ohm; RESC1608X60N; Mouser Part Number 660-UR73D1JTTD10L0F
R8, R12, R13: 1k; RES_V0603_VIS; Manufacturer_Part_Number CRCW06031K00JNEAIF
R9, R10: 5k1; ERA3AEB101V; Mouser Part Number 667-ERA-3AED512V
R14: 100k; RES_R0603_ROM; Manufacturer_Part_Number ESR03EZPF1003

Connections:
/Battery Management/SCL: IC1.5 (SCL); also elsewhere on the board
/Battery Management/SDA: IC1.4 (SDA); also elsewhere on the board
/Charging Circuit/USB_C: C8.1, IC1.22 (VBUS), Q3.3 (S); also elsewhere on the board
/To MCU OR System/MCU_USB_DETECT: R11.1, R12.1; also elsewhere on the board
/To MCU OR System/USB_C_Interrupt: IC1.9 (GPIO3); also elsewhere on the board
/USB-C/CC1: IC1.17 (CC1), J1.A5 (CC1), R10.1
/USB-C/CC2: IC1.16 (CC2), J1.B5 (CC2), R9.1
/USB-C/FAULT: IC1.6 (GPIO4), R6.1
/USB-C/VCC: IC1.24 (VCC), Q2.2 (D), R7.2
GND: C4.2, C5.2, C6.2, C7.2, C8.2, C9.1, IC1.3 (GND_1), IC1.25 (GND_2), J1.1 (MH1), J1.2 (MH2), J1.3 (MH3), J1.4 (MH4), J1.A12 (GND_1), J1.B12 (GND_2), LED1.1 (K), NTC1.2, R9.2, R10.2, R13.2, R14.1; also elsewhere on the board
unnamed: D1.2 (A), R14.2
unnamed: C7.1, IC1.15 (IFB)
unnamed: IC1.13 (OTP), NTC1.1
unnamed: IC1.23 (PWR_EN), R8.2
unnamed: C5.1, IC1.12 (V3VD)
unnamed: C6.1, IC1.20 (V5V)
unnamed: LED1.2 (A), R6.2
unnamed: Q2.1 (G), Q3.1 (G), R8.1
unnamed: Q2.3 (S), Q3.2 (D)
unnamed: R12.2, R13.1
VBUS: C4.1, C9.2, D1.1 (K), IC1.1 (ISENP), J1.A9 (VBUS_1), J1.B9 (VBUS_2), R7.1, R11.2

Notes on the sheet:
All standard Passive componenets are 0603 imperial
USB-C Connector & PD
USB-C Connector
VBUS => 15V
USB-PD C info
OverVoltage protection VBUS > Vz(27V)
MCU Needs to detect when a USB-C cable is plugged in MCU_USB_DETECT is at 3.3V max 5mA will be drawn

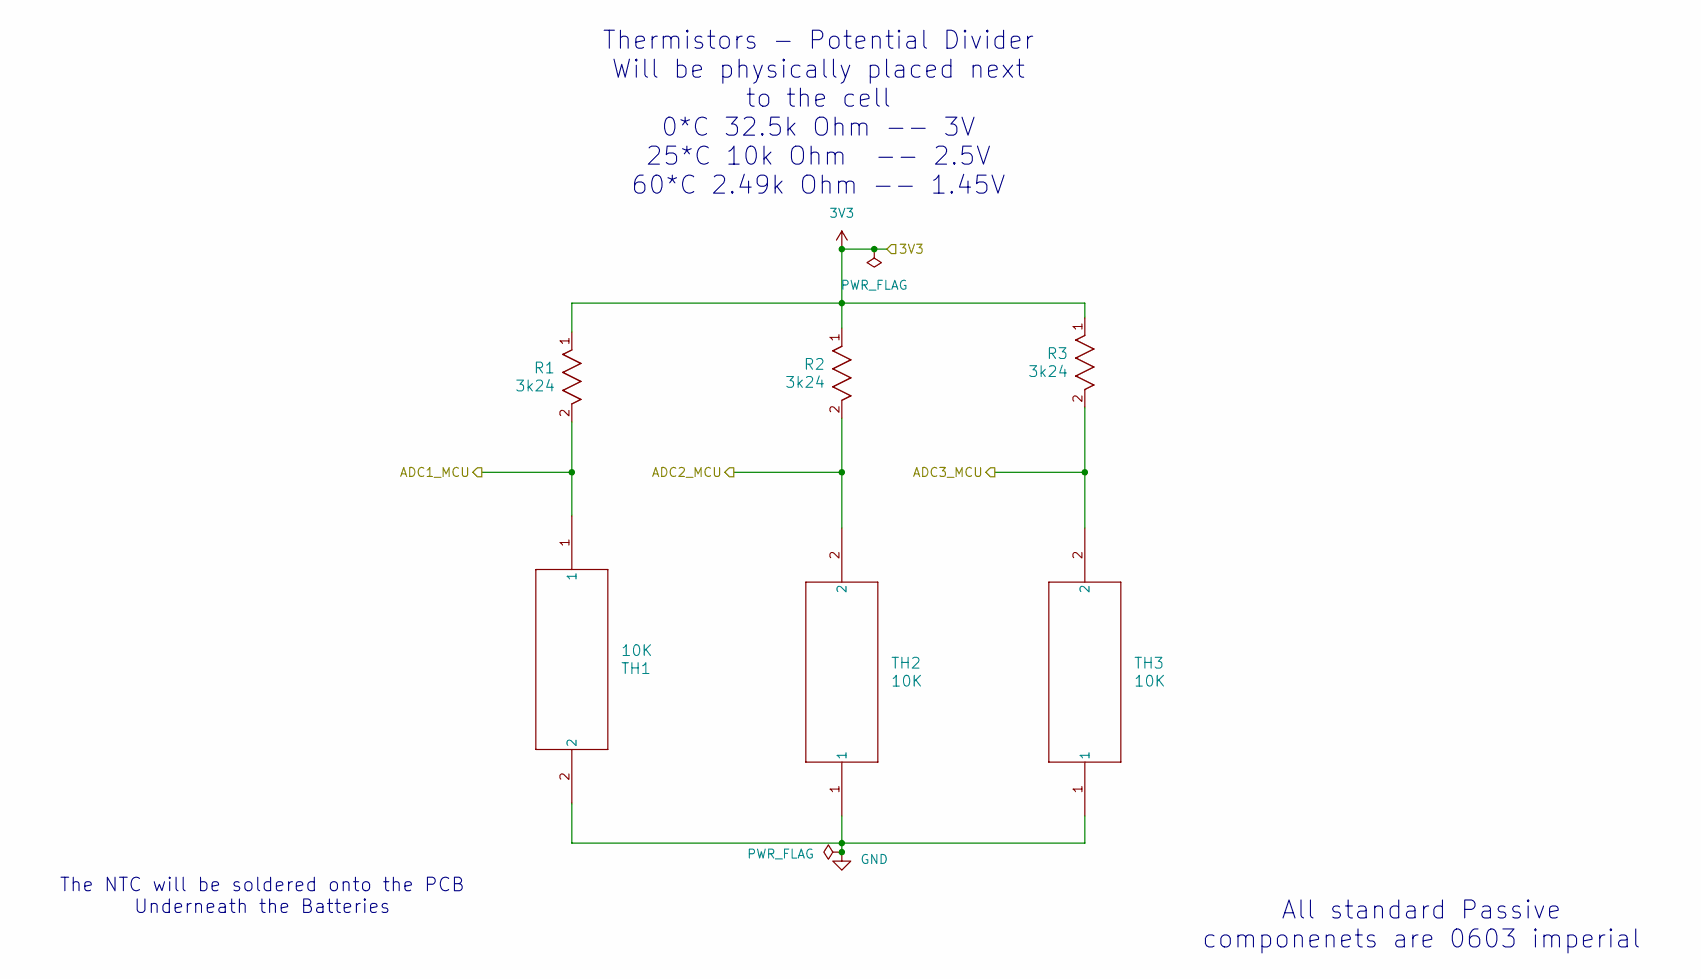
[picture p38: schematic Thermistors.kicad_sch]

Parts:
R1, R2, R3: 3k24; RC0603N_YAG; Manufacturer_Part_Number RC0603FR-073K24L
TH1, TH2, TH3: 10K; THERMISTORS_100E3103HB0_VIS; Manufacturer_Part_Number NTCLE100E3103HB0

Connections:
3V3: R1.1, R2.1, R3.1; also elsewhere on the board
/Thermistors/ADC1_MCU: R1.2, TH1.1; also elsewhere on the board
/Thermistors/ADC2_MCU: R2.2, TH2.2; also elsewhere on the board
/Thermistors/ADC3_MCU: R3.2, TH3.2; also elsewhere on the board
GND: TH1.2, TH2.1, TH3.1; also elsewhere on the board

Notes on the sheet:
Thermistors - Potential Divider Will be physically placed next to the cell 0*C 32.5k Ohm -- 3V 25*C 10k Ohm -- 2.5V 60*C 2.49k Ohm -- 1.45V
The NTC will be soldered onto the PCB Underneath the Batteries
All standard Passive componenets are 0603 imperial

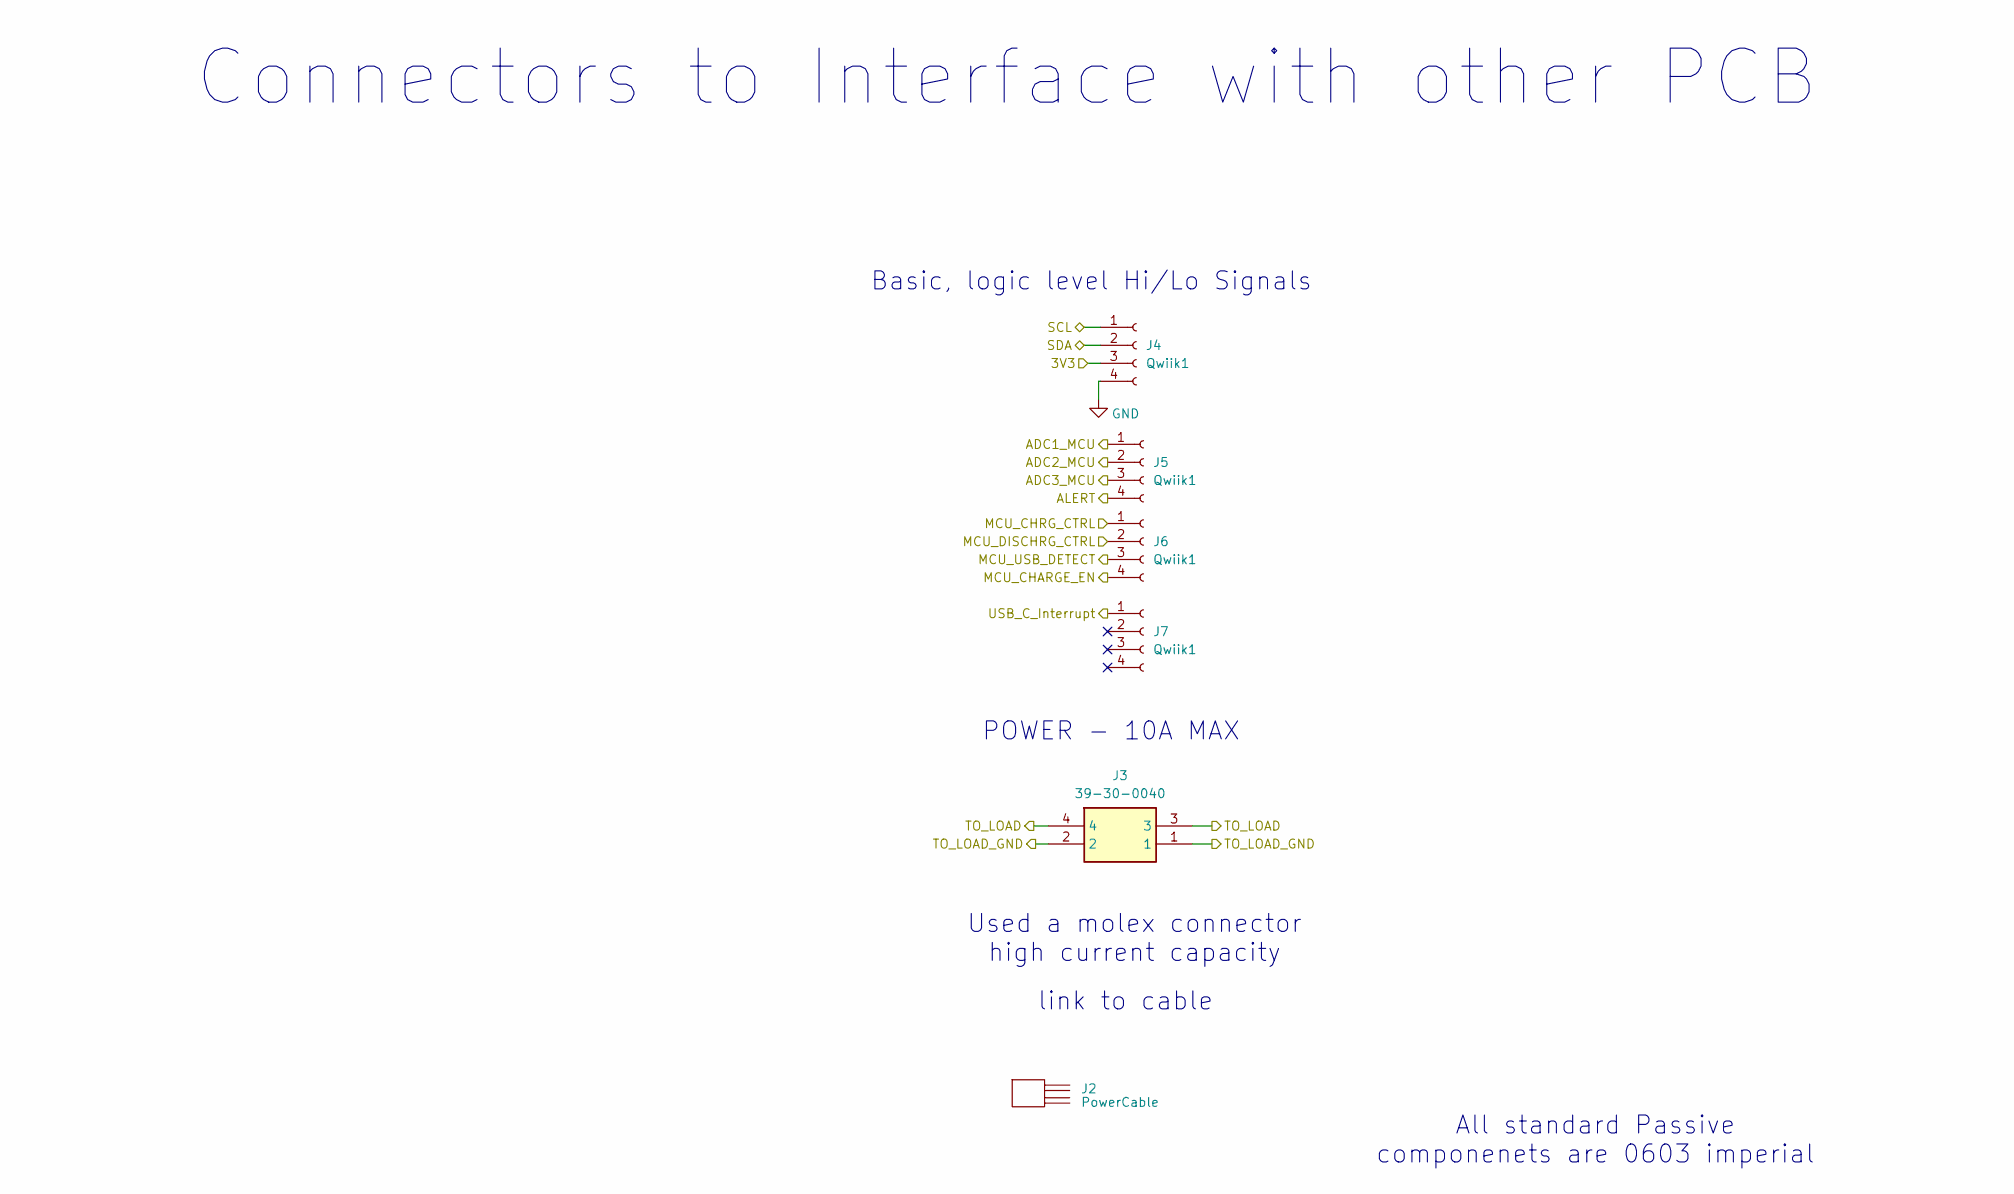
[picture p39: schematic MCUConnections.kicad_sch]

Parts:
J2: PowerCable; Manufacturer_Part_Number 45135-0401
J3: 39-30-0040; 39-30-Y040; Mouser Part Number 538-39-30-0040
J4, J5, J6, J7: Qwiik1; JST_SH_BM04B-SRSS-TB_1x04-1MP_P1.00mm_Vertical; Manufacturer_Part_Number SM04B-SRSS-TB(LFSN)

Connections:
3V3: J4.3; also elsewhere on the board
/Battery Management/ALERT: J5.4; also elsewhere on the board
/Battery Management/MCU_CHRG_CTRL: J6.1; also elsewhere on the board
/Battery Management/MCU_DISCHRG_CTRL: J6.2; also elsewhere on the board
/Battery Management/SCL: J4.1; also elsewhere on the board
/Battery Management/SDA: J4.2; also elsewhere on the board
/Battery Management/TO_LOAD: J3.3, J3.4; also elsewhere on the board
/Battery Management/TO_LOAD_GND: J3.1, J3.2; also elsewhere on the board
/Charging Circuit/MCU_CHARGE_EN: J6.4; also elsewhere on the board
/Thermistors/ADC1_MCU: J5.1; also elsewhere on the board
/Thermistors/ADC2_MCU: J5.2; also elsewhere on the board
/Thermistors/ADC3_MCU: J5.3; also elsewhere on the board
/To MCU OR System/MCU_USB_DETECT: J6.3; also elsewhere on the board
/To MCU OR System/USB_C_Interrupt: J7.1; also elsewhere on the board
GND: J4.4; also elsewhere on the board

Notes on the sheet:
All standard Passive componenets are 0603 imperial
POWER - 10A MAX
Basic, logic level Hi/Lo Signals
link to cable
Used a molex connector high current capacity
Connectors to Interface with other PCB
