A-ry-A/RobotSTM32Board/Robot_BMS/Robot_BMS.kicad_pcb

## KiCad design Robot_BMS/Robot_BMS.kicad_pcb (continued)

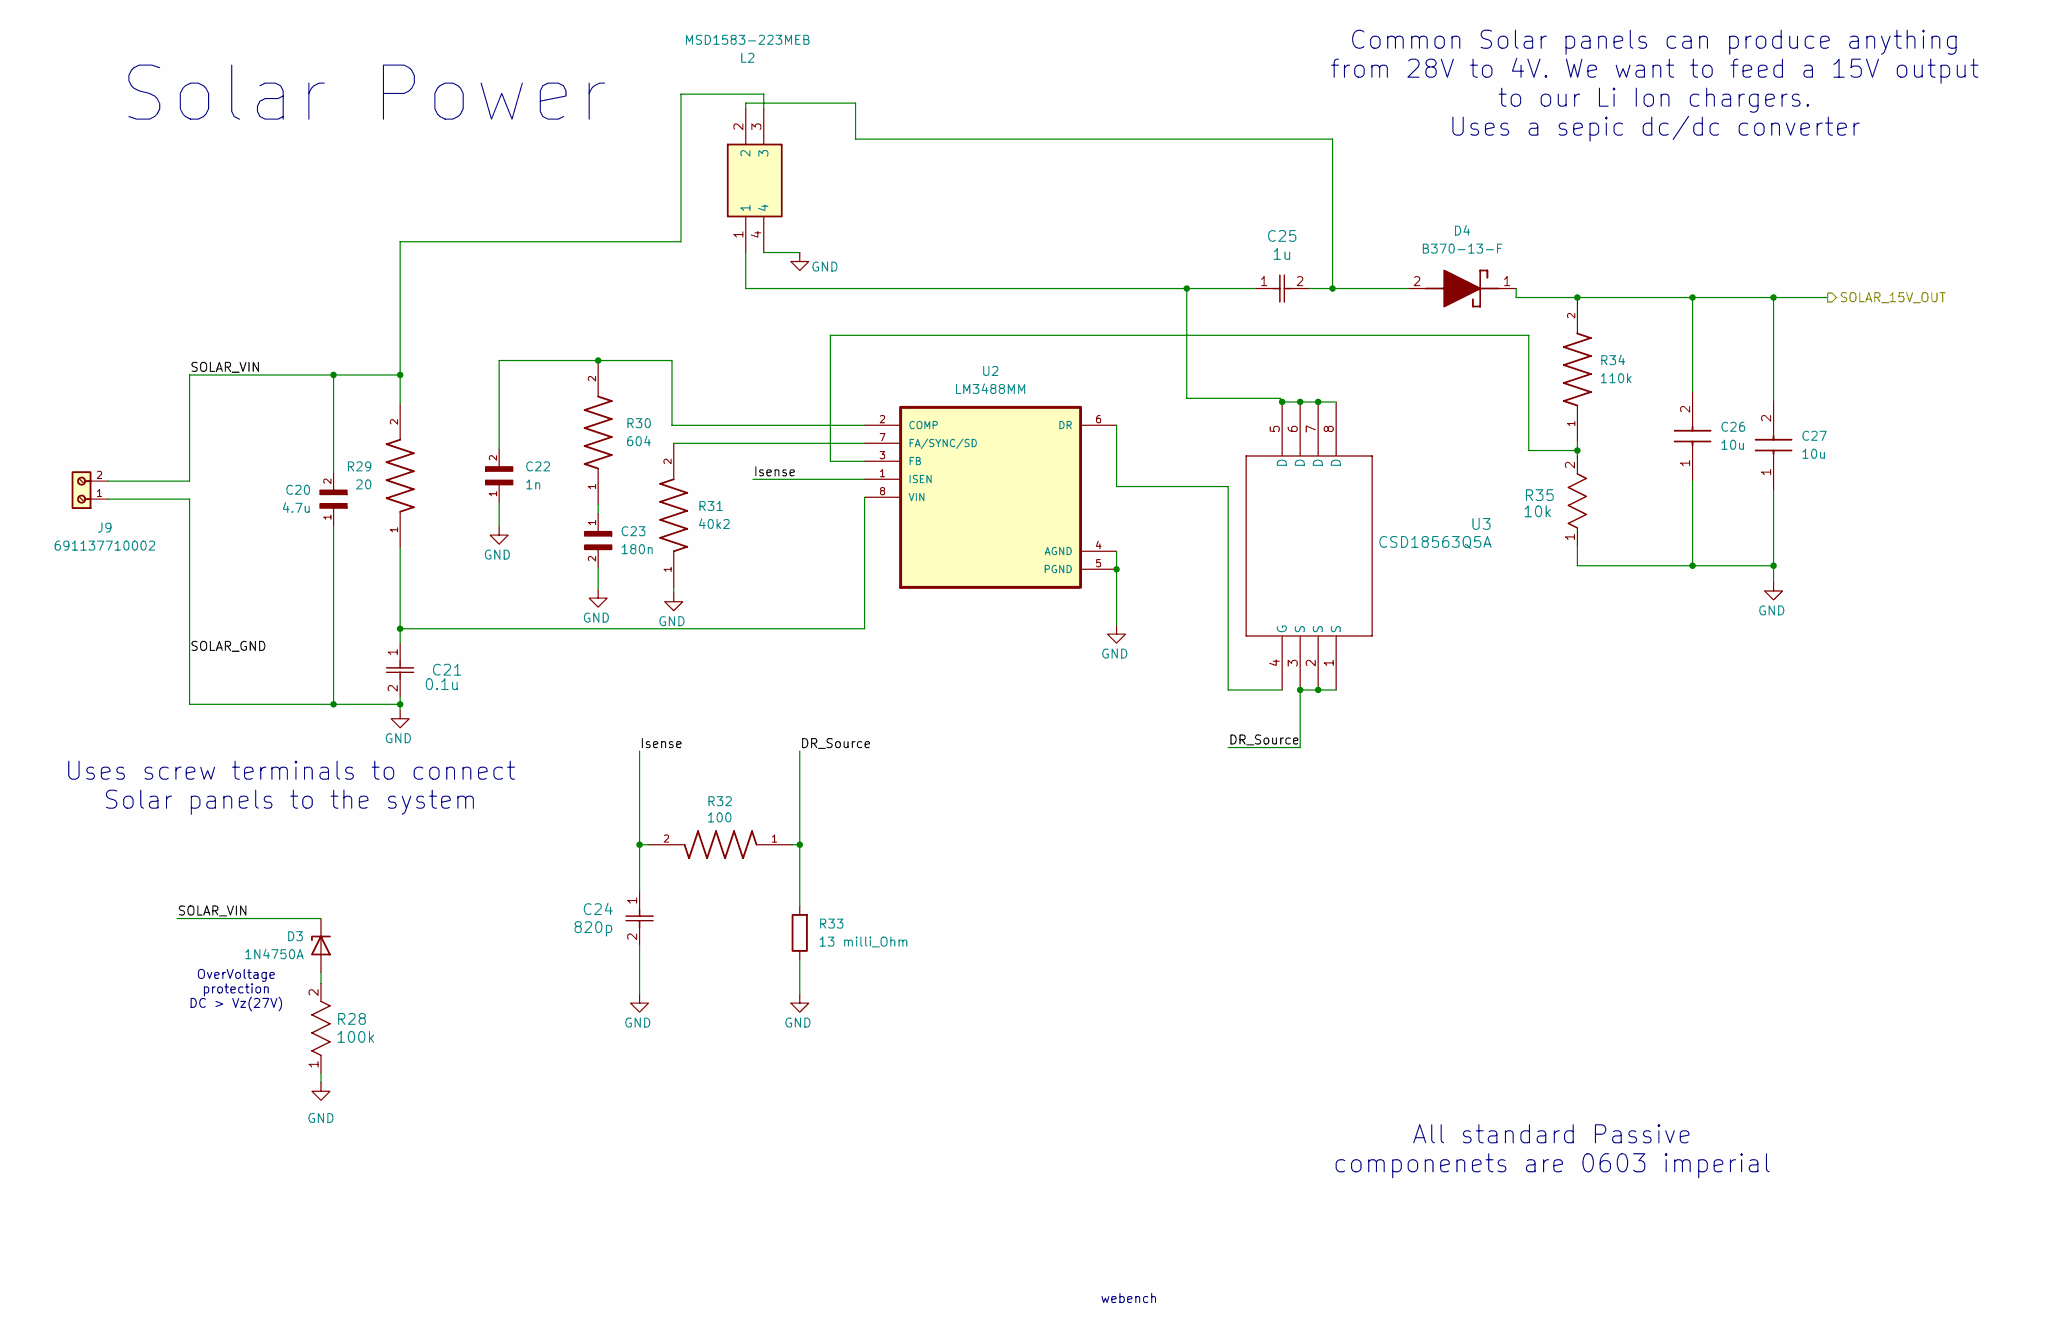
[picture p40: schematic Solar.kicad_sch]

Parts:
C20: 4.7u; CAPC1608X120N; Manufacturer_Part_Number ZRB18AR6YA475ME05L
C21: 0.1u; CAPC17595_87N_KEM; Manufacturer_Part_Number C0603C104K5RACAUTO
C22: 1n; CAPRR254W50L508T317H508; PARTREV 081816
C23: 180n; CAPC1608X90; Manufacturer_Part_Number CC0603KRX7R6BB184
C24: 820p; CAPC17795_95N_KEM; Manufacturer_Part_Number C0603X821K5RACAUTO
C25: 1u; CAP_1608_TDK; Manufacturer_Part_Number C1608X5R1H105K080AB
C26, C27: 10u; CAPC1608X90N; Mouser Part Number 187-CL10A106MA8NRNC
D3: 1N4750A; D_DO-41_SOD81_P10.16mm_Horizontal; Manufacturer_Part_Number 1N4750A
D4: B370-13-F; DIOM7959X250N; Mouser Part Number 621-B370-F
J9: 691137710002; Manufacturer_Part_Number 691137710002
L2: MSD1583-223MEB; MSD1583223MEB; Mouser Part Number 994-MSD1583-223MEB
R28: 100k; RES_R0603_ROM; Manufacturer_Part_Number ESR03EZPF1003
R29: 20; RES_ERJPA3F20R0V; PARTREV 3/1/2020
R30: 604; RESC1508X50N; Manufacturer_Part_Number CRCW0603604RFKEA
R31: 40k2; RESC1608X55N; Manufacturer_Part_Number CRCW060340K2FKEAHP
R32: 100; RESC1608X55N; PARTREV V6
R33: 13 milli_Ohm; RESC1508X50N; Manufacturer_Part_Number WFCP0603R0120FE66
R34: 110k; RESC1608X55N; Manufacturer_Part_Number CRCW0603110KFKEAC
R35: 10k; RC0603N_YAG; Manufacturer_Part_Number RC0603FR-0710KL
U2: LM3488MM; SOP65P490X110-8N; Manufacturer_Part_Number LM3488MM
U3: CSD18563Q5A; DQJ8; Manufacturer_Part_Number CSD18563Q5A

Connections:
/Charging Circuit/SOLAR_15V_OUT: C26.2, C27.2, D4.1 (K), R34.2; also elsewhere on the board
/Solar Power/DR_Source: R32.1, R33.2, U3.1 (S), U3.2 (S), U3.3 (S)
/Solar Power/Isense: C24.1, R32.2, U2.1 (ISEN)
/Solar Power/SOLAR_VIN: C20.2, D3.1 (K), J9.2, L2.3, R29.2
GND: C20.1, C21.2, C22.1, C23.2, C24.2, C26.1, C27.1, J9.1, L2.4, R28.1, R31.1, R33.1, R35.1, U2.4 (AGND), U2.5 (PGND); also elsewhere on the board
unnamed: C23.1, R30.1
unnamed: C25.1, L2.1, U3.5 (D), U3.6 (D), U3.7 (D), U3.8 (D)
unnamed: D3.2 (A), R28.2
unnamed: C25.2, D4.2 (A), L2.2
unnamed: C22.2, R30.2, U2.2 (COMP)
unnamed: U2.6 (DR), U3.4 (G)
unnamed: R31.2, U2.7 (FA/SYNC/SD)
unnamed: R34.1, R35.2, U2.3 (FB)
unnamed: C21.1, R29.1, U2.8 (VIN)

Notes on the sheet:
Uses screw terminals to connect Solar panels to the system
OverVoltage protection DC > Vz(27V)
Common Solar panels can produce anything from 28V to 4V. We want to feed a 15V output to our Li Ion chargers. Uses a sepic dc/dc converter
Solar Power
All standard Passive componenets are 0603 imperial
webench

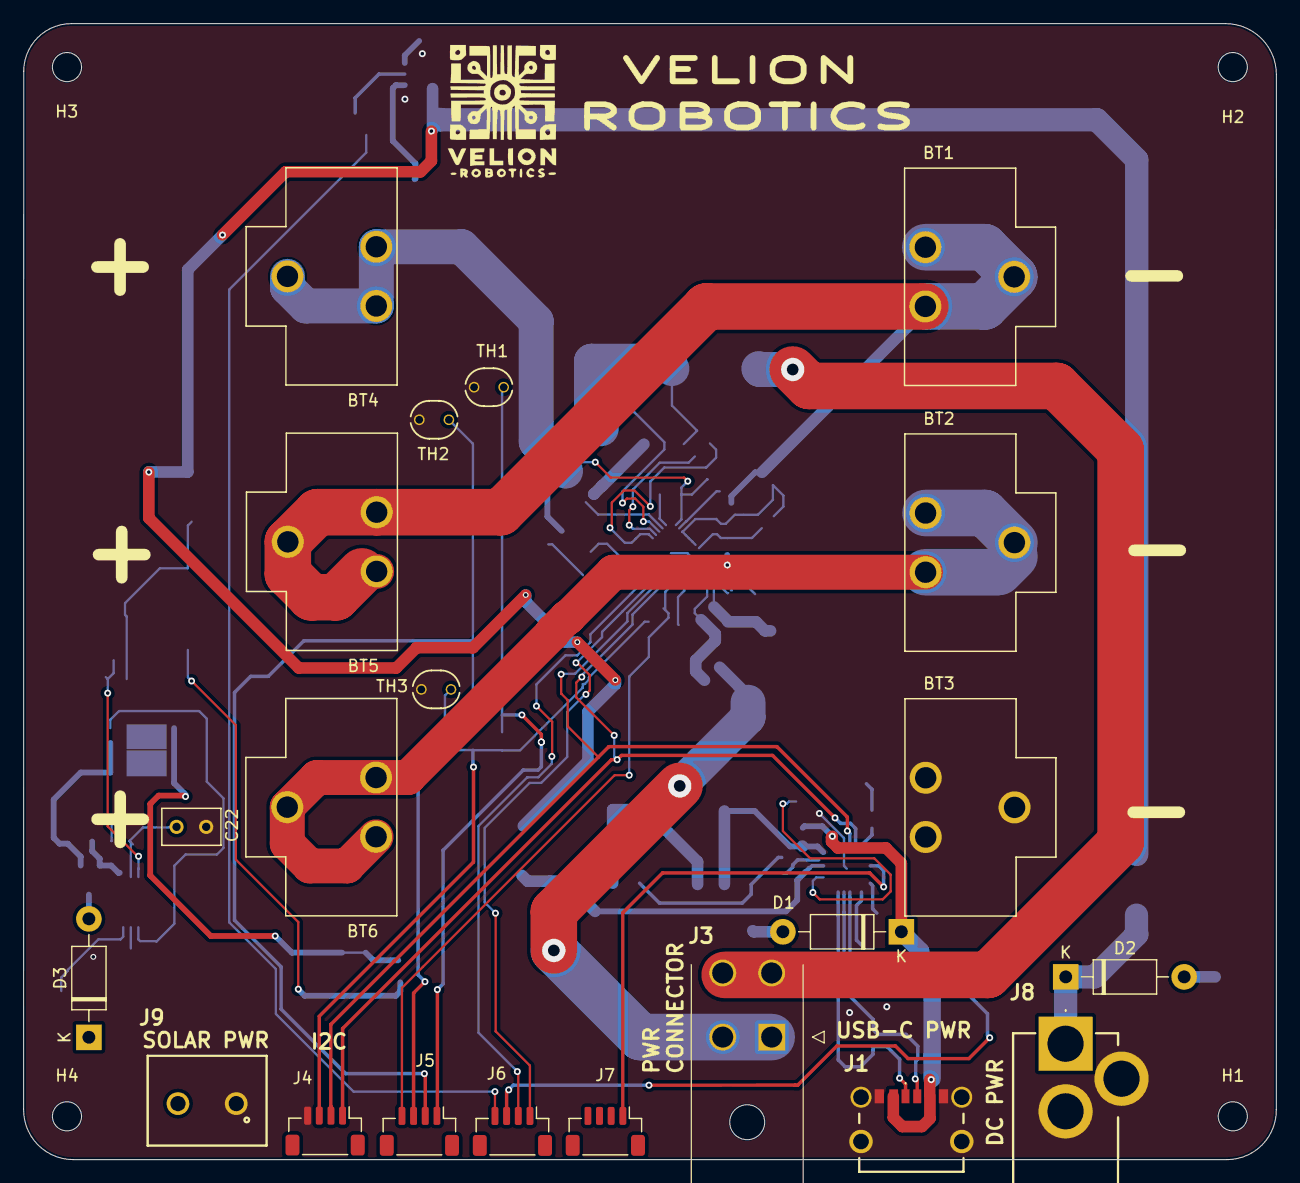
[picture p41: board Robot_BMS.kicad_pcb from above]

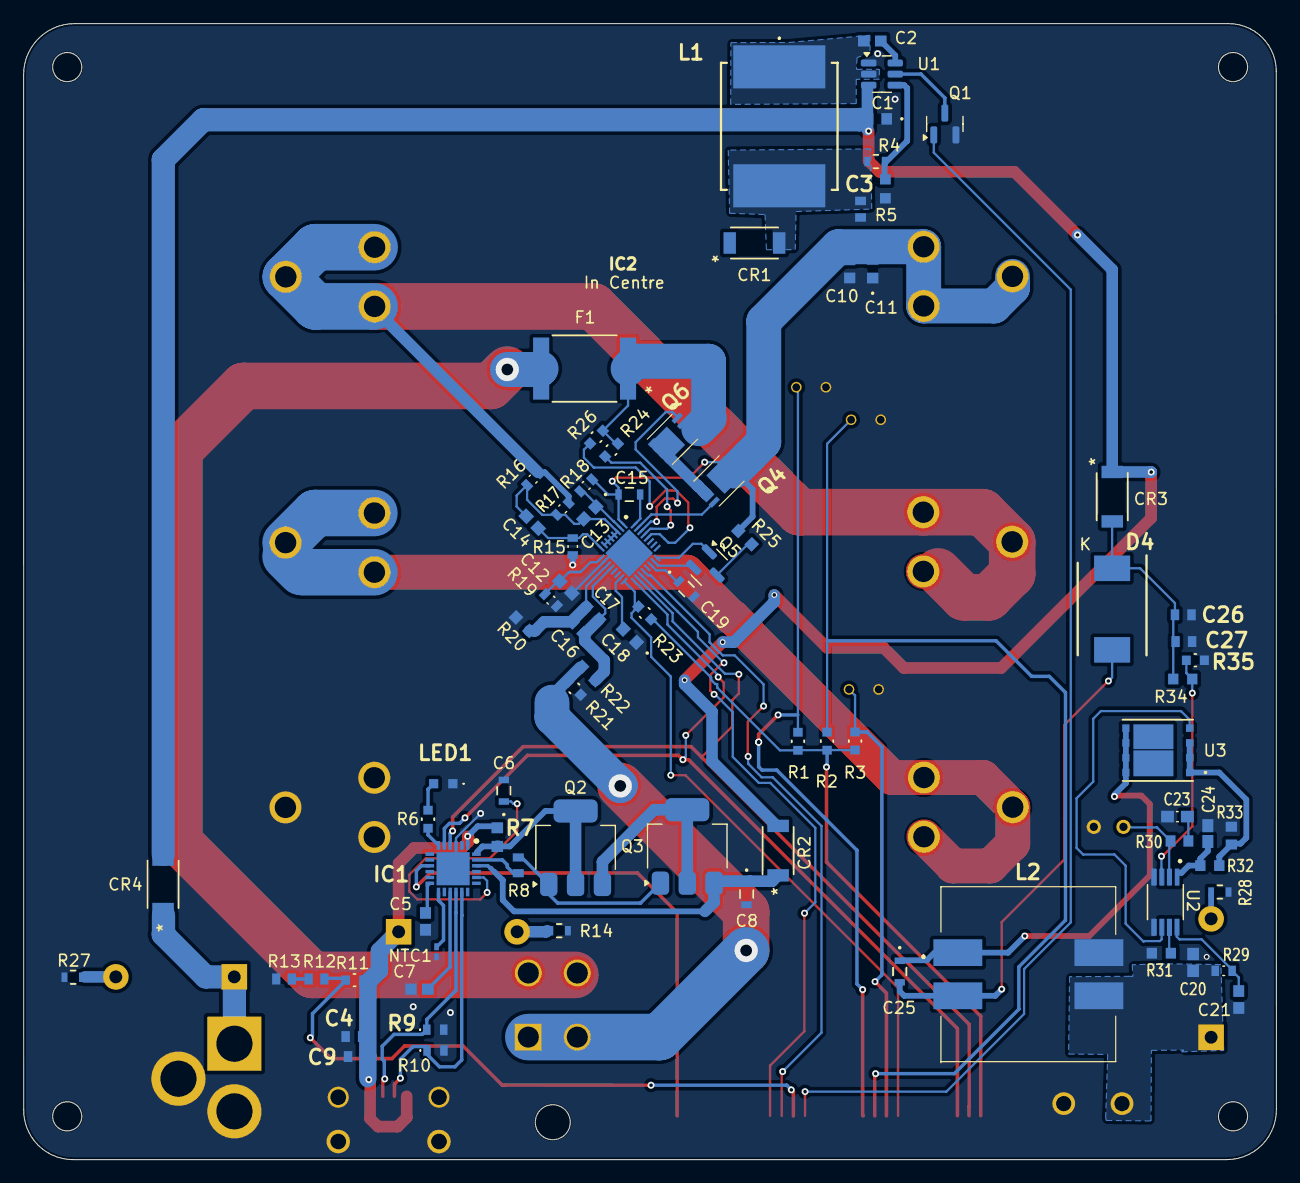
[picture p42: board Robot_BMS.kicad_pcb from below]

Board: 2 copper layers, 107.5 x 97.4 mm, 107 parts (82 on the bottom side), 73 nets.
