A-ry-A/RobotSTM32Board/RobotSTM32Board.kicad_pcb

## KiCad design RobotSTM32Board.kicad_pcb (2025-03-03)

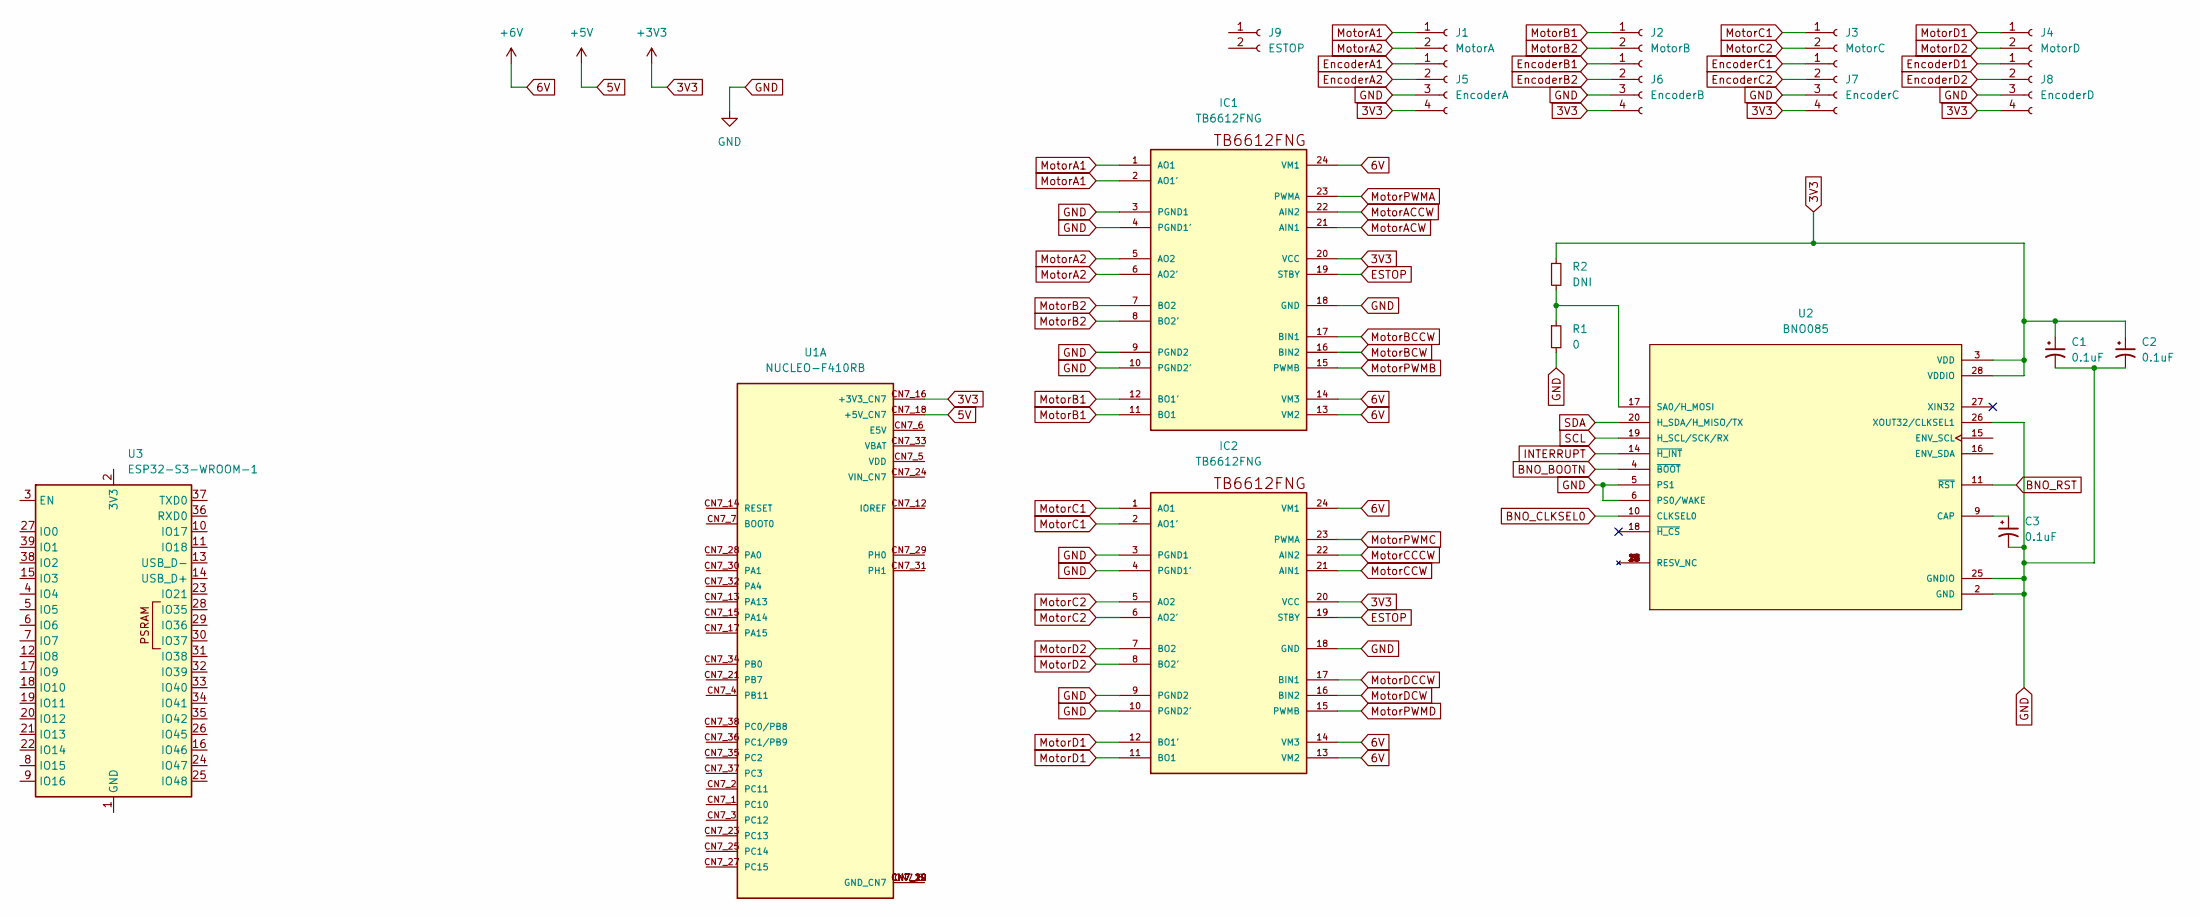
[picture p43: schematic RobotSTM32Board.kicad_sch]

Parts:
C1, C2, C3: 0.1uF; C_0603_1608Metric_Pad1.08x0.95mm_HandSolder
IC1, IC2: TB6612FNG; SSOP24
J1: MotorA; JST_XH_B2B-XH-AM_1x02_P2.50mm_Vertical
J2: MotorB; JST_XH_B2B-XH-AM_1x02_P2.50mm_Vertical
J3: MotorC; JST_XH_B2B-XH-AM_1x02_P2.50mm_Vertical
J4: MotorD; JST_XH_B2B-XH-AM_1x02_P2.50mm_Vertical
J5: EncoderA; JST_XH_B4B-XH-AM_1x04_P2.50mm_Vertical
J6: EncoderB; JST_XH_B4B-XH-AM_1x04_P2.50mm_Vertical
J7: EncoderC; JST_XH_B4B-XH-AM_1x04_P2.50mm_Vertical
J8: EncoderD; JST_XH_B4B-XH-AM_1x04_P2.50mm_Vertical
J9: ESTOP; JST_XH_B2B-XH-AM_1x02_P2.50mm_Vertical
R1: 0; R_0603_1608Metric_Pad0.98x0.95mm_HandSolder
R2: DNI; R_0603_1608Metric_Pad0.98x0.95mm_HandSolder
U1: NUCLEO-F410RB; ST_NUCLEO-F410RB; PARTREV 13
U2: BNO085; IC_BNO085; PARTREV v1.17
U3: ESP32-S3-WROOM-1

Connections:
3V3: C1.1, C2.1, IC1.20 (VCC), IC2.20 (VCC), J5.4, J6.4, J7.4, J8.4, R2.1, U1.CN7_16 (+3V3_CN7), U2.3 (VDD), U2.28 (VDDIO)
5V: U1.CN7_18 (+5V_CN7)
6V: IC1.13 (VM2), IC1.14 (VM3), IC1.24 (VM1), IC2.13 (VM2), IC2.14 (VM3), IC2.24 (VM1)
BNO_BOOTN: U2.4 (~BOOT)
BNO_CLKSEL0: U2.10 (CLKSEL0)
BNO_RST: U2.11 (~RST)
ESTOP: IC1.19 (STBY), IC2.19 (STBY)
EncoderA1: J5.1
EncoderA2: J5.2
EncoderB1: J6.1
EncoderB2: J6.2
EncoderC1: J7.1
EncoderC2: J7.2
EncoderD1: J8.1
EncoderD2: J8.2
GND: C1.2, C2.2, C3.2, IC1.3 (PGND1), IC1.4 (PGND1'), IC1.9 (PGND2), IC1.10 (PGND2'), IC1.18 (GND), IC2.3 (PGND1), IC2.4 (PGND1'), IC2.9 (PGND2), IC2.10 (PGND2'), IC2.18 (GND), J5.3, J6.3, J7.3, J8.3, R1.2, U2.2 (GND), U2.5 (PS1), U2.6 (PS0/WAKE), U2.25 (GNDIO), U2.26 (XOUT32/CLKSEL1)
INTERRUPT: U2.14 (~H_INT)
MotorA1: IC1.1 (AO1), IC1.2 (AO1'), J1.1
MotorA2: IC1.5 (AO2), IC1.6 (AO2'), J1.2
MotorACCW: IC1.22 (AIN2)
MotorACW: IC1.21 (AIN1)
MotorB1: IC1.11 (BO1), IC1.12 (BO1'), J2.1
MotorB2: IC1.7 (BO2), IC1.8 (BO2'), J2.2
MotorBCCW: IC1.17 (BIN1)
MotorBCW: IC1.16 (BIN2)
MotorC1: IC2.1 (AO1), IC2.2 (AO1'), J3.1
MotorC2: IC2.5 (AO2), IC2.6 (AO2'), J3.2
MotorCCCW: IC2.22 (AIN2)
MotorCCW: IC2.21 (AIN1)
MotorD1: IC2.11 (BO1), IC2.12 (BO1'), J4.1
MotorD2: IC2.7 (BO2), IC2.8 (BO2'), J4.2
MotorDCCW: IC2.17 (BIN1)
MotorDCW: IC2.16 (BIN2)
MotorPWMA: IC1.23 (PWMA)
MotorPWMB: IC1.15 (PWMB)
MotorPWMC: IC2.23 (PWMA)
MotorPWMD: IC2.15 (PWMB)
unnamed: U1.CN7_8 (GND_CN7), U1.CN7_19 (GND_CN7), U1.CN7_20 (GND_CN7), U1.CN7_22 (GND_CN7)
unnamed: C3.1, U2.9 (CAP)
unnamed: R1.1, R2.2, U2.17 (SA0/H_MOSI)
unnamed: U3.1 (GND), U3.40 (GND), U3.41 (GND)
SCL: U2.19 (H_SCL/SCK/RX)
SDA: U2.20 (H_SDA/H_MISO/TX)

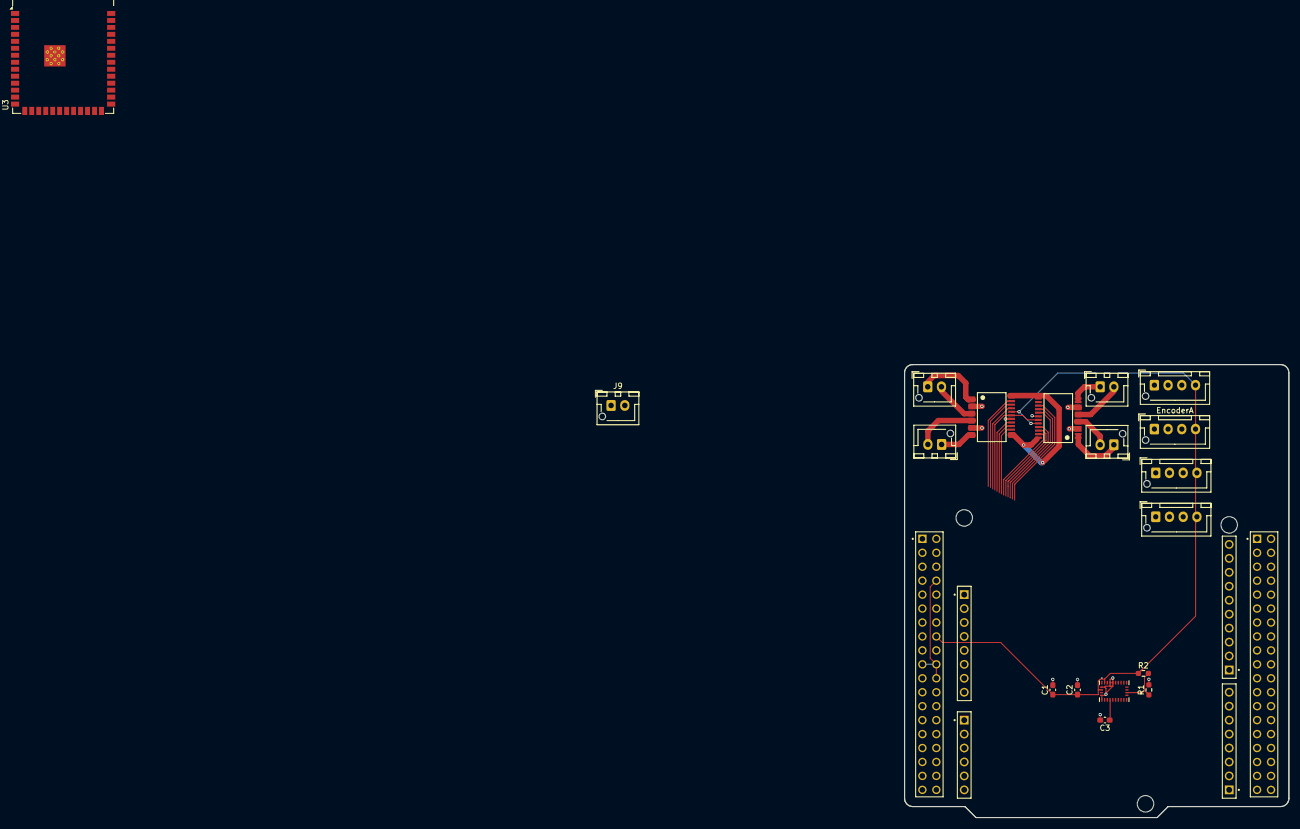
[picture p44: board RobotSTM32Board.kicad_pcb from above]

Board: 2 copper layers, 70.0 x 82.5 mm, 19 parts (0 on the bottom side), 16 nets.
