A-ry-A/RobotSTM32Board/Robot_BMS/Robot_BMS_4_Layer.kicad_pcb

## KiCad design Robot_BMS/Robot_BMS_4_Layer.kicad_pcb (2025-03-27)

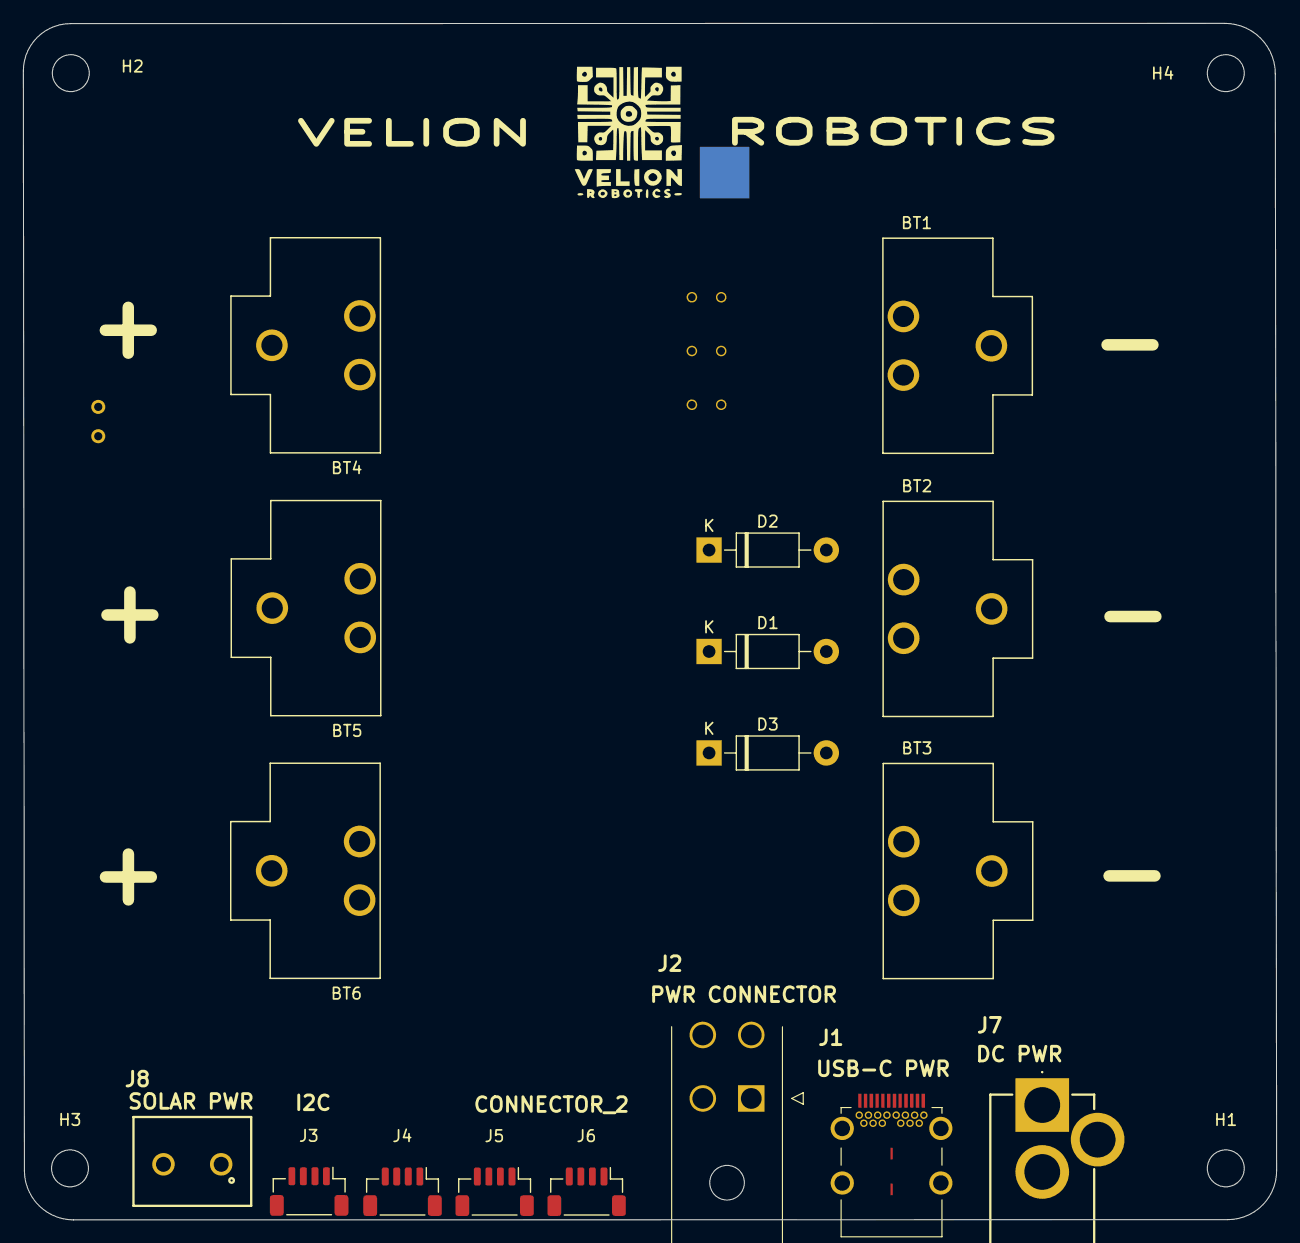
[picture p45: board Robot_BMS_4_Layer.kicad_pcb from above]

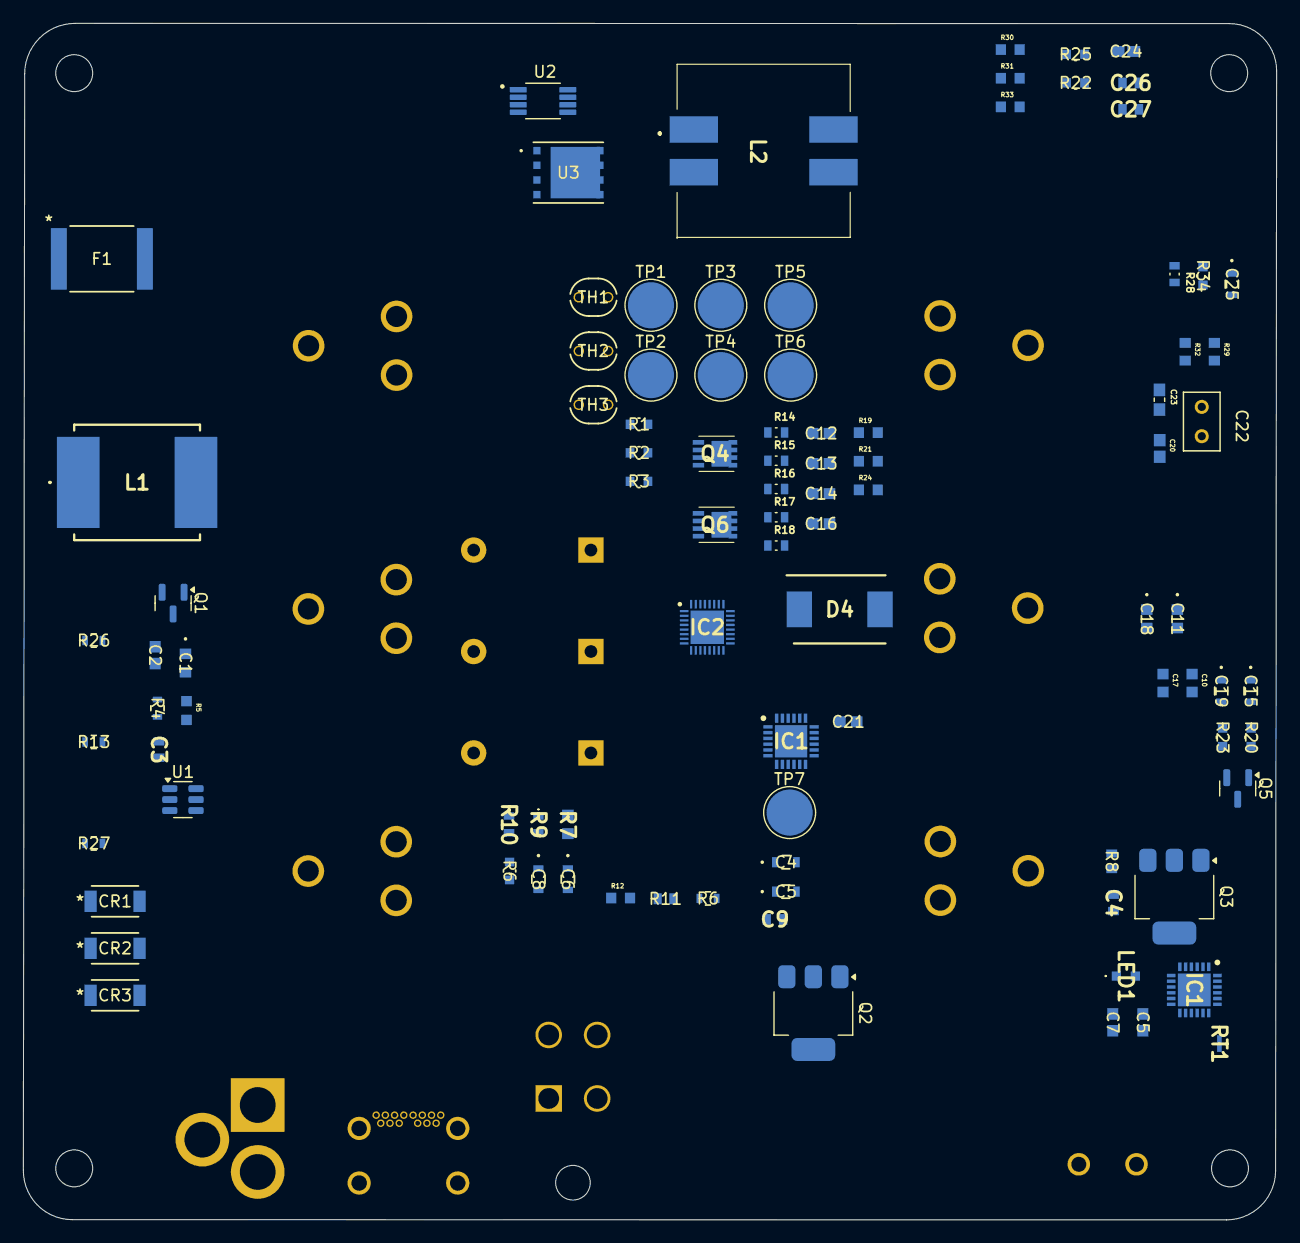
[picture p46: board Robot_BMS_4_Layer.kicad_pcb from below]

Board: 4 copper layers, 108.6 x 103.7 mm, 116 parts (95 on the bottom side), 74 nets, no tracks yet.

Parts:
BT1, BT2, BT3, BT4, BT5, BT6: BK-18650-CLIP; BAT_BK-18650-CLIP
C1, C11, C18: 2.2u; CAP_GRM188R61H225KE11__MUR
C2, C5, C7, C12, C13, C14, C16, C21: 0.1u; CAPC17595_87N_KEM
C3, C4#2, C9, C26, C27: 10u; CAPC1608X90N
C4, C5#2, C6, C8, C19, C25: 1u; CAP_1608_TDK
C10, C17: 100p; CAPC1608X97N
C15: 0.47u; CAP_1608_TDK
C20: 4.7u; CAPC1608X120N
C22: 1n; CAPRR254W50L508T317H508
C23: 180n; CAPC1608X90
C24: 820p; CAPC17795_95N_KEM
CR1, CR2, CR3: CMS05TE12L_Q_M; M-FLAT_TOS
D1, D2, D3: 1N4750A; D_DO-41_SOD81_P10.16mm_Horizontal
D4: B370-13-F; DIOM7959X250N
F1: MF-LSMF500/16X-2; FUSE_MF-LSMF185&slash_33X_BRN
H1, H2, H3, H4: MountingHole; MountingHole_3.2mm_M3
IC1: AP33772DKZ-13; QFN50P400X400X80-25N-D
IC1#2: STUSB4710AQTR; QFN50P400X400X100-25N-D
IC2: BQ76922RSNR; QFN40P400X400X80-33N-D
J1: 632723300011
J2: 39-30-0040; 39-30-Y040
J3, J4, J5, J6: Qwiik1; JST_SH_BM04B-SRSS-TB_1x04-1MP_P1.00mm_Vertical
J7: 694108301002
J8: 691137710002
L1: ETQ-P5M220YSC; ETQP5M220YSC
L2: MSD1583-223MEB; MSD1583223MEB
LED1: SML-D12V8WT86; SMLD12V8WT86
Q1, Q5: 2N7002; SOT-23
Q2, Q3: NDT3055L; SOT-223-3_TabPin2
Q4, Q6: SIS413DN-T1-GE3; SIS862DNT1GE3
R1, R2, R3: 3k24; RC0603N_YAG
R4, R6#2, R13, R26, R27: 100k; RES_R0603_ROM
R5: 4.81k; RESC1608X55N
R6, R22, R23, R25, R34: 10k; RC0603N_YAG
R7: 10 milli_ohm; RESC1608X60N
R8, R11: 1k; RES_V0603_VIS
R9, R10: 5k1; ERA3AEB101V
R12, R19, R21, R24, R31: 100; RESC1608X55N
R14, R15, R16, R17, R18, R28: 20; RES_ERJPA3F20R0V
R20: 1 mOhm; RC0603N_YAG
R29: 604; RESC1508X50N
R30: 40k2; RESC1608X55N
R32: 13 milli_Ohm; RESC1508X50N
R33: 110k; RESC1608X55N
RT1: 10k; THRMC0603X33N
TH1, TH2, TH3: 10K; THERMISTORS_100E3103HB0_VIS
TP1, TP2: NTC1; TestPoint_Pad_D4.0mm
TP3, TP4: NTC2; TestPoint_Pad_D4.0mm
TP5, TP6: NTC3; TestPoint_Pad_D4.0mm
TP7: VBUS_Test; TestPoint_Pad_D4.0mm
U1: TPS54308DDCR; SOT-23-6
U2: LM3488MM; SOP65P490X110-8N
U3: CSD18563Q5A; DQJ8

Connections:
3V3: J3.3, R1.1, R2.1, R3.1, R22.2
/Battery Management/ALERT: IC2.16 (ALERT), J4.4, R22.1
/Battery Management/LD: IC2.28 (LD), R25.1
/Battery Management/MCU_CHRG_CTRL: IC2.19 (CFETOFF), J5.1
/Battery Management/MCU_DISCHRG_CTRL: IC2.20 (DFETOFF), J5.2
/Battery Management/SCL: IC1.5 (SCL), IC1#2.7 (SCL), IC2.17 (SCL), J3.1
/Battery Management/SDA: IC1.4 (SDA), IC1#2.8 (SDA), IC2.18 (SDA), J3.2
/Battery Management/TO_LOAD: F1.2, J2.3, J2.4
/Charging Circuit/CHARGE_IN: C1.2, CR1.2, CR2.2, CR3.2, U1.3 (VIN)
/Charging Circuit/DC_BARREL_JACK: CR3.1, D2.1 (K), J7.1
/Charging Circuit/MCU_CHARGE_EN: J5.4, Q1.1 (G)
/Charging Circuit/SOLAR_15V_OUT: C26.2, C27.2, CR2.1, D4.1 (K), R33.2
/Charging Circuit/USB_C: C8.1, CR1.1, IC1.22 (VBUS), Q3.3 (S)
/Solar Power/DR_Source: R31.1, R32.2, U3.1 (S), U3.2 (S), U3.3 (S)
/Solar Power/Isense: C24.1, R31.2, U2.1 (ISEN)
/Solar Power/SOLAR_VIN: C20.2, D3.1 (K), J8.2, L2.3, R28.2
/Thermistors/ADC1_MCU: J4.1, R1.2, TP1.1
/Thermistors/ADC2_MCU: J4.2, R2.2, TP3.1
/Thermistors/ADC3_MCU: J4.3, R3.2, TP5.1
/To MCU OR System/USB_C_Interrupt: IC1.9 (GPIO3), J6.1
/USB-C/CC1: IC1.17 (CC1), IC1#2.2 (CC1), J1.A5 (CC1), R10.1
/USB-C/CC2: IC1.16 (CC2), IC1#2.4 (CC2), J1.B5 (CC2), R9.1
/USB-C/D+: J1.A6 (DP1), J1.B6 (DP2), R12.2
/USB-C/D-: J1.A7 (DN1), J1.B7 (DN2), R12.1
/USB-C/FAULT: IC1.6 (GPIO4), R6.1
/USB-C/VCC: IC1.24 (VCC), Q2.2 (D), R7.2
BATT+: BT4.1_1, BT4.1_2, BT4.1_3, C3.2, C10.1, C11.2, C15.1, IC2.1 (BAT), L1.2, Q4.5 (D_1), Q4.6 (D_2), Q4.7 (D_3), Q4.8 (D_4), R4.2, R17.1, R24.2
GND: BT3.1_1, BT3.1_2, BT3.1_3, C1.1, C3.1, C4.2, C4#2.2, C5.2, C5#2.2, C6.2, C7.2, C8.2, C9.1, C10.2, C11.1, C12.2, C18.1, C19.2, C20.1, C21.2, C22.1, C23.2, C24.2, C26.1, C27.1, IC1.3 (GND_1), IC1.25 (GND_2), IC1#2.10 (GND), IC1#2.14 (SEL_PDO4), IC1#2.25 (EP), IC2.10 (VSS), IC2.33 (EP), J1.1 (GND_1), J1.2 (GND_2), J1.A1 (GND_3), J1.A12 (GND_4), J1.B1 (GND_5), J1.B12 (GND_6), J2.1, J2.2, J3.4, J5.3, J7.2, J7.3, J8.1, L2.4, LED1.1 (K), Q1.2 (S), R5.2, R6#2.1, R9.2, R10.2, R11.2, R13.1, R18.1, R19.1, R20.1, R20.2, R21.1, R26.1, R27.1, R30.1, R32.1, R34.1, RT1.2, TP2.1, TP4.1, TP6.1, U1.1 (GND), U2.4 (AGND), U2.5 (PGND)
unnamed: BT1.1_1, BT1.1_2, BT1.1_3, BT5.1_1, BT5.1_2, BT5.1_3, R15.1, R16.1
unnamed: BT2.1_1, BT2.1_2, BT2.1_3, BT6.1_1, BT6.1_2, BT6.1_3, R14.1
unnamed: C23.1, R29.1
unnamed: C25.1, L2.1, U3.5 (D), U3.6 (D), U3.7 (D), U3.8 (D)
unnamed: D1.2 (A), R13.2
unnamed: D2.2 (A), R26.2
unnamed: D3.2 (A), R27.2
unnamed: C25.2, D4.2 (A), L2.2
unnamed: IC1#2.13 (ADDR0), R6#2.2
unnamed: C7.1, IC1.15 (IFB)
unnamed: IC1.13 (OTP), RT1.1
unnamed: IC1.23 (PWR_EN), R8.2
unnamed: C5.1, IC1.12 (V3VD)
unnamed: C6.1, IC1.20 (V5V)
unnamed: C5#2.1, IC1#2.21 (VREG_1V2)
unnamed: C4.1, IC1#2.23 (VREG_2V7)
unnamed: IC2.24 (BREG), Q5.1 (G)
unnamed: IC2.31 (CHG), Q4.4 (G)
unnamed: C15.2, IC2.32 (CP1)
unnamed: IC2.30 (DSG), Q6.4 (G)
unnamed: IC2.29 (PACK), R23.1
unnamed: C19.1, IC2.22 (REG1)
unnamed: C18.2, IC2.15 (REG18)
unnamed: IC2.23 (REGIN), Q5.2 (S)
unnamed: C16.2, C17.2, IC2.12 (SRN), R21.2
unnamed: C16.1, C17.1, IC2.11 (SRP), R19.2
unnamed: C12.1, IC2.9 (VC0), R18.2
unnamed: C14.2, IC2.8 (VC1), R14.2
unnamed: C13.2, C14.1, IC2.3 (VC4A), IC2.4 (VC4B), IC2.5 (VC3A), IC2.6 (VC3B), IC2.7 (VC2), R15.2, R16.2
unnamed: C13.1, IC2.2 (VC5), R17.2
unnamed: LED1.2 (A), R6.2
unnamed: Q1.3 (D), U1.5 (EN)
unnamed: Q2.1 (G), Q3.1 (G), R8.1
unnamed: Q2.3 (S), Q3.2 (D)
unnamed: Q4.1 (S_1), Q4.2 (S_2), Q4.3 (S_3), Q6.5 (D_1), Q6.6 (D_2), Q6.7 (D_3), Q6.8 (D_4)
unnamed: Q5.3 (D), R24.1
unnamed: F1.1, Q6.1 (S_1), Q6.2 (S_2), Q6.3 (S_3), R23.2, R25.2
unnamed: C2.1, U1.6 (BOOT)
unnamed: R4.1, R5.1, U1.4 (FB)
unnamed: C2.2, L1.1, U1.2 (SW)
unnamed: C22.2, R29.2, U2.2 (COMP)
unnamed: U2.6 (DR), U3.4 (G)
unnamed: R30.2, U2.7 (FA/SYNC/SD)
unnamed: R33.1, R34.2, U2.3 (FB)
unnamed: C21.1, R28.1, U2.8 (VIN)
VBUS: C4#2.1, C9.2, D1.1 (K), IC1.1 (ISENP), IC1#2.18 (VBUS_SENSE), IC1#2.24 (VDD), J1.A4 (VBUS_1), J1.A9 (VBUS_2), J1.B4 (VBUS_3), J1.B9 (VBUS_4), R7.1, R11.1, TP7.1
