A-ry-A/RobotSTM32Board/(commit log)

2025-03-03 added motor stuff to schematic and IC
    [BNO085.step, RobotSTM32Board.kicad_pcb, RobotSTM32Board.kicad_sch, TB6612FNG.step]
2025-03-10 did motor driver and sttuff
    [RobotSTM32Board.kicad_sch]
2025-03-10 Robot_BMS folder containg BMS_Schematic added
    [BQ34Z100PWR-R2.stp, EDI2CAP.CFG, Robot_BMS.kicad_pcb, Robot_BMS.kicad_sch, STUSB4710AQTR.stp, chips.prt, sop65p640x120-14n.psm]
2025-03-10 NTC's implemented
    [Robot_BMS.kicad_sch]
2025-03-10 Battery Protection IC implemented, N Channel Fet selected
    [Robot_BMS.kicad_sch, SIS413DN-T1-GE3.stp]
2025-03-11 comments on Bat Protection IC added
    [Robot_BMS.kicad_sch]
2025-03-11 Li+ Ion implemented into schematic for one of the cells
    [KT_EELP41.12-S2U1-25-2X4X-5-R18.stp, KY_EELP41.22_Q2T1-36-A8J8-020-R18.stp, Robot_BMS.kicad_sch, SML-D12V8WT86.stp]
2025-03-11 Removed USB-C PD chip in favor of using resistors to neogitate 5V 3A (15W) charging
    [Robot_BMS.kicad_sch]
2025-03-12 working on thee fuel gauge
    [Robot_BMS.kicad_sch]
2025-03-12 implementing hierarchical schematics
    [BatteryProtection.kicad_sch, Charging.kicad_sch, Robot_BMS.kicad_sch, Thermistors.kicad_sch]
2025-03-12 cleaning up hierarchical schematics
    [BatteryConnectors.kicad_sch, BatteryProtection.kicad_sch, Charging.kicad_sch, FuelGauge.kicad_sch, MCUConnections.kicad_sch, Robot_BMS.kicad_sch, Thermistors.kicad_sch, USBC.kicad_sch]
2025-03-15 DC power supply added via dc Barrel jack
    [BatteryConnectors.kicad_sch, BatteryProtection.kicad_sch, Charging.kicad_sch, DCJ200-10-A-XX-K_REVA.step, DC_Barrel_Jack.kicad_sch, FuelGauge.kicad_sch, MCUConnections.kicad_sch, Power.kicad_sch]
2025-03-17 implementing sepic converter for Solar power input
    [BatteryConnectors.kicad_sch, Charging.kicad_sch, DC_Barrel_Jack.kicad_sch, FuelGauge.kicad_sch, LM3488MM.step, Robot_BMS.kicad_sch, Solar.kicad_sch, USBC.kicad_sch]
2025-03-17 USB-c PD to 15V
    [691137710002.step, BSC093N04LS_G.stp, Charging.kicad_sch, DRQ125-220-R.stp, Robot_BMS.kicad_sch, Solar.kicad_sch, USBC.kicad_sch]
2025-03-17 solar charger set to 15V
    [B370-13-F.stp, BatteryConnectors.kicad_sch, Charging.kicad_sch, ChargingV2.kicad_sch, DC_Barrel_Jack.kicad_sch, FuelGauge.kicad_sch, MSD1583-223MEB.stp, Robot_BMS.kicad_sch]
2025-03-18 ex charging circuit last appearence
    [694108301002.stp, BatteryConnectors.kicad_sch, Charging.kicad_sch, ChargingV2.kicad_sch, DC_Barrel_Jack.kicad_sch, FuelGauge.kicad_sch, Robot_BMS.kicad_sch, Solar.kicad_sch]
2025-03-18 battery management ic is being added
    [BQ76922RSNR.stp, Battery Management.kicad_sch, BatteryProtection.kicad_sch, BatteryProtectionV2.kicad_sch, ChargingV2.kicad_sch, Robot_BMS.kicad_sch]
2025-03-18 System drawing down on top schematic, will start inputting footprints
    [Battery Management.kicad_sch, ChargingV2.kicad_sch, DC_Barrel_Jack.kicad_sch, MCUConnections.kicad_sch, Robot_BMS.kicad_sch, Solar.kicad_sch, USBC.kicad_sch]
2025-03-19 adding footprints and actual passive components
    [Battery Management.kicad_sch, ChargingV2.kicad_sch, DC_Barrel_Jack.kicad_sch, MCUConnections.kicad_sch, RC0603N_YAG.step, Robot_BMS.kicad_sch, Solar.kicad_sch, Thermistors.kicad_sch]
2025-03-19 adding footprints and actual passive components pt.2
    [Battery Management.kicad_sch, CAP_GRM188R61H225KE11__MUR.step, CCS_CCSTD_0603_L1.75W0.95T0.87B0.35.step, ChargingV2.kicad_sch, ETQ-P5M220YSC.stp, NTCLE100E3102.step, Solar.kicad_sch, Thermistors.kicad_sch]
2025-03-19 still adding in symbols & footprints for passives
    [AT0603DRE07100RL.step, Battery Management.kicad_sch, CAP_1608_TDK.step, CL10A106MA8NRNC.stp, ChargingV2.kicad_sch, RES_R0603_ROM.step, RES_V0603_VIS.step, RN73H1JTTD4811B25.step]
2025-03-19 all symbols footprints & models added
    [Battery Management.kicad_sch, CAP_1608_TDK.step, CC0603KRX7R6BB184.step, CCS_CCSTD_0603_L1.77W0.95T0.95B0.45.step, CRCW0603110KFKEAC.step, CRCW060340K2FKEAHP.step, CRCW0603604RFKEA.step, ChargingV2.kicad_sch]
2025-03-20 BOM done, with total price £40
    [Battery Management.kicad_sch, ChargingV2.kicad_sch, DC_Barrel_Jack.kicad_sch, MCUConnections.kicad_sch, Robot_BMS.csv, Robot_BMS.kicad_pcb, Robot_BMSV1.csv, Robot_BMSV1.xlsx]
2025-03-24 switching usb c pd chip to ap33772 due to better support online
    [AP33772DKZ-13.stp, Battery Management.kicad_sch, DC_Barrel_Jack.kicad_sch, MCUConnections.kicad_sch, MF-USML450_12.stp, Robot_BMS.kicad_pcb, Robot_BMS.kicad_sch, Solar.kicad_sch]
2025-03-24 mid way implementing new usb-pd chip
    [ChargingV2.kicad_sch, ERA-3AED512V.stp, NCP03XH103F05RL.stp, Robot_BMS.kicad_sch, UR73D1JTTD10L0F.stp, USBC.kicad_sch]
2025-03-24 placed connectors for BMS PCB
    [39-30-0040.stp, BK-18650-CLIP.step, Battery Management.kicad_sch, DC_Barrel_Jack.kicad_sch, MCUConnections.kicad_sch, Robot_BMS.kicad_pcb, Robot_BMS.kicad_sch, S6B-PH-K-S_LF__SN_.step]
2025-03-24 Battery holders placed for 18650 fit
    [Robot_BMS.kicad_pcb]
2025-03-27 adding qwik connectors replacing old jst ph 6 pin ones
    [Battery Management.kicad_sch, MCUConnections.kicad_sch, Robot_BMS.kicad_pcb]
2025-03-27 qwikk connector 3d model and footprint in RobotBMS
    [MCUConnections.kicad_sch, Robot_BMS.kicad_pcb]
2025-03-27 creation of seperate 4 layer pcb for individual technical report
    [Battery Management.kicad_sch, DC_Barrel_Jack.kicad_sch, MCUConnections.kicad_sch, Robot_BMS_4_Layer.kicad_pcb, Solar.kicad_sch]
2025-04-01 PCB layout up to charging circuit
    [Battery Management.kicad_sch, ChargingV2.kicad_sch, Robot_BMS.kicad_pcb, Robot_BMS.step, Robot_BMSV1.xlsx, Thermistors.kicad_sch, UJC-H-G-SMT-2-P6-TR.stp, USBC.kicad_sch]
2025-04-03 halfway throgh battery management pcb layout
    [Battery Management.kicad_sch, ChargingV2.kicad_sch, DC_Barrel_Jack.kicad_sch, MCUConnections.kicad_sch, PRT-13113.stp, Robot_BMS.csv, Robot_BMS.kicad_pcb, Robot_BMS.kicad_sch]
2025-04-11 first pcb layout done, beginning of DRC checks
    [Robot_BMS.kicad_pcb]
2025-04-15 resize board for chanin m2.5 holes
    [Robot_BMS-BOTTOM.gbr, Robot_BMS-B_Mask.gbr, Robot_BMS-B_Paste.gbr, Robot_BMS-B_Silkscreen.gbr, Robot_BMS-Edge_Cuts.gbr, Robot_BMS-F_Mask.gbr, Robot_BMS-F_Paste.gbr, Robot_BMS-F_Silkscreen.gbr]
2025-04-18 manufacture ready
    [Battery Management.kicad_sch, ChargingV2.kicad_sch, DC_Barrel_Jack.kicad_sch, MCUConnections.kicad_sch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]
